shakursiam/ssl16-acoustic-camera/hardware/exports/erc_report.txt

ERC report (2026-10-29T23:49:08, Encoding UTF8)
Report includes: Errors, Warnings

***** Sheet /
[lib_symbol_issues]: The current configuration does not include the symbol library 'PTS526SM15SMTR2 LFS'
    ; warning
    @(172.72 mm, 97.79 mm): Symbol SW4 [PTS526_SM15_SMTR2_LFS]
[lib_symbol_issues]: The current configuration does not include the symbol library 'PTS526SM15SMTR2 LFS'
    ; warning
    @(173.99 mm, 62.23 mm): Symbol SW3 [PTS526_SM15_SMTR2_LFS]
[lib_symbol_issues]: The current configuration does not include the symbol library 'EEEFK1V471AQ_cap'
    ; warning
    @(246.38 mm, 125.73 mm): Symbol C106 [EEEFK1V471AQ]
[lib_symbol_issues]: Symbol '_1' not found in symbol library 'XL2596S-5.0E1'
    ; warning
    @(294.64 mm, 128.27 mm): Symbol U7 [_1]
[footprint_link_issues]: Footprint 'SOT_RG1_DIO' not found in library 'footprints'
    ; warning
    @(303.53 mm, 229.87 mm): Symbol U8 [AP2112K-3.3TRG1]
[lib_symbol_mismatch]: Symbol 'AP2112K-3.3TRG1' doesn't match copy in library 'AP2112K-3.3TRG1'
    ; warning
    @(303.53 mm, 229.87 mm): Symbol U8 [AP2112K-3.3TRG1]
[lib_symbol_issues]: The current configuration does not include the symbol library 'AMRM00101040470'
    ; warning
    @(323.85 mm, 125.73 mm): Symbol L2 [AMRM00101040470MA1]
[lib_symbol_issues]: The current configuration does not include the symbol library 'EEEFK1V471AQ_cap'
    ; warning
    @(350.52 mm, 135.89 mm): Symbol C107 [EEEFK1V471AQ]
[endpoint_off_grid]: Symbol pin or wire end off connection grid
    ; warning
    @(28.575 mm, 41.91 mm): Horizontal Wire, length 15.24 mm
[endpoint_off_grid]: Symbol pin or wire end off connection grid
    ; warning
    @(28.575 mm, 41.91 mm): Vertical Wire, length 36.83 mm
[endpoint_off_grid]: Symbol pin or wire end off connection grid
    ; warning
    @(28.575 mm, 78.74 mm): Horizontal Wire, length 48.895 mm
[endpoint_off_grid]: Symbol pin or wire end off connection grid
    ; warning
    @(43.815 mm, 41.91 mm): Horizontal Wire, length 5.715 mm
[endpoint_off_grid]: Symbol pin or wire end off connection grid
    ; warning
    @(43.815 mm, 46.99 mm): Symbol R601 Pin 2 [Passive, Line]
[endpoint_off_grid]: Symbol pin or wire end off connection grid
    ; warning
    @(43.815 mm, 54.61 mm): Symbol #PWR0601 Pin 1 [Power input, Line]
[endpoint_off_grid]: Symbol pin or wire end off connection grid
    ; warning
    @(43.815 mm, 54.61 mm): Symbol D601 Pin 1 [K, Passive, Line]
[endpoint_off_grid]: Symbol pin or wire end off connection grid
    ; warning
    @(49.53 mm, 41.91 mm): Horizontal Wire, length 0.635 mm
[endpoint_off_grid]: Symbol pin or wire end off connection grid
    ; warning
    @(50.165 mm, 41.91 mm): Vertical Wire, length 5.08 mm
[endpoint_off_grid]: Symbol pin or wire end off connection grid
    ; warning
    @(50.165 mm, 52.07 mm): Vertical Wire, length 3.81 mm
[endpoint_off_grid]: Symbol pin or wire end off connection grid
    ; warning
    @(50.165 mm, 52.07 mm): Symbol C102 Pin 2 [Passive, Line]
[endpoint_off_grid]: Symbol pin or wire end off connection grid
    ; warning
    @(50.165 mm, 55.88 mm): Vertical Wire, length 5.08 mm
[endpoint_off_grid]: Symbol pin or wire end off connection grid
    ; warning
    @(50.165 mm, 60.96 mm): Symbol #PWR0119 Pin 1 [Power input, Line]
[endpoint_off_grid]: Symbol pin or wire end off connection grid
    ; warning
    @(56.515 mm, 41.91 mm): Vertical Wire, length 5.08 mm
[endpoint_off_grid]: Symbol pin or wire end off connection grid
    ; warning
    @(56.515 mm, 41.91 mm): Horizontal Wire, length 6.35 mm
[endpoint_off_grid]: Symbol pin or wire end off connection grid
    ; warning
    @(56.515 mm, 52.07 mm): Symbol C103 Pin 2 [Passive, Line]
[endpoint_off_grid]: Symbol pin or wire end off connection grid
    ; warning
    @(56.515 mm, 52.07 mm): Vertical Wire, length 3.81 mm
[endpoint_off_grid]: Symbol pin or wire end off connection grid
    ; warning
    @(56.515 mm, 55.88 mm): Horizontal Wire, length 6.35 mm
[lib_symbol_issues]: The current configuration does not include the symbol library 'Sd_card'
    ; warning
    @(77.47 mm, 71.12 mm): Symbol J601 [1040310811]
[lib_symbol_mismatch]: Symbol 'R_Small_US' doesn't match copy in library 'Device'
    ; warning
    @(173.355 mm, 31.115 mm): Symbol R604 [R_Small_US]
[endpoint_off_grid]: Symbol pin or wire end off connection grid
    ; warning
    @(173.355 mm, 33.655 mm): Symbol R604 Pin 1 [Passive, Line]
[endpoint_off_grid]: Symbol pin or wire end off connection grid
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
    ; warning
    @(80.01 mm, 64.77 mm): Symbol U2 [TLV320ADC5140IRTWR]
[lib_symbol_issues]: The current configuration does not include the symbol library 'TLV320ADC5140IRTWR'
    ; warning
    @(72.39 mm, 67.31 mm): Symbol U4 [TLV320ADC5140IRTWR]

***** Sheet /MCU/
[pin_to_pin]: Pins of type Output and Power output are connected
    ; error
    @(68.58 mm, 220.98 mm): Symbol U9 Pin 3 [ALERT, Output, Line]
    @(133.35 mm, 81.28 mm): Symbol J601 Pin 6 [VSS, Power output, Line]
[power_pin_not_driven]: Input Power pin not driven by any Output Power pins
    ; error
    @(289.56 mm, 175.26 mm): Symbol #PWR053 Pin 1 [Power input, Line]
[power_pin_not_driven]: Input Power pin not driven by any Output Power pins
    ; error
    @(350.52 mm, 119.38 mm): Symbol #PWR052 Pin 1 [Power input, Line]
[power_pin_not_driven]: Input Power pin not driven by any Output Power pins
    ; error
    @(359.41 mm, 87.63 mm): Symbol #PWR049 Pin 1 [Power input, Line]
[power_pin_not_driven]: Input Power pin not driven by any Output Power pins
    ; error
    @(364.49 mm, 226.06 mm): Symbol #PWR056 Pin 1 [Power input, Line]
[no_connect_dangling]: Unconnected "no connection" flag
    ; warning
    @(66.04 mm, 54.61 mm): No Connect
[no_connect_dangling]: Unconnected "no connection" flag
    ; warning
    @(66.04 mm, 68.58 mm): No Connect
[no_connect_dangling]: Unconnected "no connection" flag
    ; warning
    @(68.58 mm, 54.61 mm): No Connect
[no_connect_dangling]: Unconnected "no connection" flag
    ; warning
    @(68.58 mm, 68.58 mm): No Connect
[multiple_net_names]: Both FSYNC and IO7_WS are attached to the same items; FSYNC will be used in the netlist
    ; warning
    @(76.20 mm, 77.47 mm): Global Label 'FSYNC'
    @(71.12 mm, 78.74 mm): Global Label 'IO7_WS'
[pin_to_pin]: Pins of type Unspecified and Unspecified are connected
    ; warning
    @(157.48 mm, 95.25 mm): Symbol SW4 Pin 1 [1, Unspecified, Line]
    @(157.48 mm, 100.33 mm): Symbol SW4 Pin 2 [2, Unspecified, Line]
[pin_to_pin]: Pins of type Unspecified and Power input are connected
    ; warning
    @(157.48 mm, 100.33 mm): Symbol SW4 Pin 2 [2, Unspecified, Line]
    @(153.67 mm, 102.87 mm): Symbol #PWR072 Pin 1 [Power input, Line]
[pin_to_pin]: Pins of type Unspecified and Unspecified are connected
    ; warning
    @(158.75 mm, 59.69 mm): Symbol SW3 Pin 1 [1, Unspecified, Line]
    @(158.75 mm, 64.77 mm): Symbol SW3 Pin 2 [2, Unspecified, Line]
[pin_to_pin]: Pins of type Unspecified and Power input are connected
    ; warning
    @(158.75 mm, 64.77 mm): Symbol SW3 Pin 2 [2, Unspecified, Line]
    @(154.94 mm, 78.74 mm): Symbol #PWR045 Pin 1 [Power input, Line]
[pin_to_pin]: Pins of type Unspecified and Passive are connected
    ; warning
    @(185.42 mm, 95.25 mm): Symbol SW4 Pin 4 [4, Unspecified, Line]
    @(189.23 mm, 95.25 mm): Symbol TP2_BOOT1 Pin 1 [1, Passive, Line]
[pin_to_pin]: Pins of type Unspecified and Unspecified are connected
    ; warning
    @(185.42 mm, 100.33 mm): Symbol SW4 Pin 3 [3, Unspecified, Line]
    @(185.42 mm, 95.25 mm): Symbol SW4 Pin 4 [4, Unspecified, Line]
[pin_to_pin]: Pins of type Unspecified and Passive are connected
    ; warning
    @(186.69 mm, 59.69 mm): Symbol SW3 Pin 4 [4, Unspecified, Line]
    @(190.50 mm, 64.77 mm): Symbol R2 Pin 1 [Passive, Line]
[pin_to_pin]: Pins of type Unspecified and Passive are connected
    ; warning
    @(186.69 mm, 64.77 mm): Symbol SW3 Pin 3 [3, Unspecified, Line]
    @(190.50 mm, 64.77 mm): Symbol R2 Pin 1 [Passive, Line]
[pin_to_pin]: Pins of type Unspecified and Passive are connected
    ; warning
    @(303.53 mm, 229.87 mm): Symbol U8 Pin 1 [VIN, Unspecified, Line]
    @(294.64 mm, 233.68 mm): Symbol R6 Pin 2 [Passive, Line]
[pin_to_pin]: Pins of type Unspecified and Passive are connected
    ; warning
    @(303.53 mm, 233.68 mm): Symbol U8 Pin 3 [EN, Unspecified, Line]
    @(299.72 mm, 233.68 mm): Symbol R6 Pin 1 [Passive, Line]
[pin_to_pin]: Pins of type Unspecified and Passive are connected
    ; warning
    @(303.53 mm, 237.49 mm): Symbol U8 Pin 2 [GND, Unspecified, Line]
    @(289.56 mm, 241.30 mm): Symbol C57 Pin 1 [Passive, Line]
[pin_to_pin]: Pins of type Unspecified and Output are connected
    ; warning
    @(323.85 mm, 125.73 mm): Symbol L2 Pin 2 [2, Unspecified, Line]
    @(312.42 mm, 128.27 mm): Symbol U7 Pin 2 [5V, Output, Line]
[pin_to_pin]: Pins of type Unspecified and Passive are connected
    ; warning
    @(339.09 mm, 125.73 mm): Symbol L2 Pin 1 [1, Unspecified, Line]
    @(345.44 mm, 125.73 mm): Symbol 5V1 Pin 1 [1, Passive, Line]
[pin_to_pin]: Pins of type Unspecified and Passive are connected
    ; warning
    @(344.17 mm, 229.87 mm): Symbol U8 Pin 5 [VOUT, Unspecified, Line]
    @(354.33 mm, 233.68 mm): Symbol C58 Pin 2 [Passive, Line]

***** Sheet /SD Card/
[pin_to_pin]: Pins of type Unspecified and Passive are connected
    ; warning
    @(77.47 mm, 76.20 mm): Symbol J601 Pin 3 [CMD, Unspecified, Line]
    @(178.435 mm, 33.655 mm): Symbol R606 Pin 1 [Passive, Line]
[pin_to_pin]: Pins of type Unspecified and Bidirectional are connected
    ; warning
    @(77.47 mm, 81.28 mm): Symbol J601 Pin 5 [CLK, Unspecified, Line]
    @(87.63 mm, 73.66 mm): Symbol U5 Pin 5 [IO5, Bidirectional, Line]
[pin_to_pin]: Pins of type Unspecified and Power input are connected
    ; warning
    @(133.35 mm, 71.12 mm): Symbol J601 Pin 10 [SW_DETECT, Unspecified, Line]
    @(139.70 mm, 68.58 mm): Symbol #PWR0122 Pin 1 [Power input, Line]
[pin_to_pin]: Pins of type Unspecified and Passive are connected
    ; warning
    @(133.35 mm, 73.66 mm): Symbol J601 Pin 9 [SW_DETECT, Unspecified, Line]
    @(182.88 mm, 36.83 mm): Symbol R607 Pin 1 [Passive, Line]

***** Sheet /ADC_1/
[power_pin_not_driven]: Input Power pin not driven by any Output Power pins
    ; error
    @(49.53 mm, 52.07 mm): Symbol U1 Pin 2 [AREG, Power input, Line]
[power_pin_not_driven]: Input Power pin not driven by any Output Power pins
    ; error
    @(167.64 mm, 54.61 mm): Symbol MK2 Pin 2 [V_{DD}, Power input, Line]
[pin_to_pin]: Pins of type Unspecified and Passive are connected
    ; warning
    @(49.53 mm, 62.23 mm): Symbol U1 Pin 3 [VREF, Unspecified, Line]
    @(46.99 mm, 62.23 mm): Symbol C77 Pin 2 [Passive, Line]
[pin_to_pin]: Pins of type Unspecified and Passive are connected
    ; warning
    @(49.53 mm, 82.55 mm): Symbol U1 Pin 5 [MICBIAS, Unspecified, Line]
    @(41.91 mm, 82.55 mm): Symbol C100 Pin 2 [Passive, Line]
[pin_to_pin]: Pins of type Bidirectional and Power output are connected
    ; warning
    @(95.25 mm, 62.23 mm): Symbol U1 Pin 15 [ADDR1_MISO, Bidirectional, Line]
    @(133.35 mm, 81.28 mm): Symbol J601 Pin 6 [VSS, Power output, Line]
[pin_to_pin]: Pins of type Unspecified and Power input are connected
    ; warning
    @(95.25 mm, 163.83 mm): Symbol U1 Pin 25 [EPAD, Unspecified, Line]
    @(95.25 mm, 165.10 mm): Symbol #PWR0155 Pin 1 [Power input, Line]

***** Sheet /ADC_3/
[power_pin_not_driven]: Input Power pin not driven by any Output Power pins
    ; error
    @(52.07 mm, 50.80 mm): Symbol U3 Pin 2 [AREG, Power input, Line]
[power_pin_not_driven]: Input Power pin not driven by any Output Power pins
    ; error
    @(170.18 mm, 53.34 mm): Symbol MK3 Pin 2 [V_{DD}, Power input, Line]
[pin_to_pin]: Pins of type Unspecified and Passive are connected
    ; warning
    @(52.07 mm, 60.96 mm): Symbol U3 Pin 3 [VREF, Unspecified, Line]
    @(49.53 mm, 60.96 mm): Symbol C78 Pin 2 [Passive, Line]
[pin_to_pin]: Pins of type Unspecified and Passive are connected
    ; warning
    @(52.07 mm, 81.28 mm): Symbol U3 Pin 5 [MICBIAS, Unspecified, Line]
    @(44.45 mm, 81.28 mm): Symbol C101 Pin 2 [Passive, Line]
[pin_to_pin]: Pins of type Unspecified and Power input are connected
    ; warning
    @(97.79 mm, 162.56 mm): Symbol U3 Pin 25 [EPAD, Unspecified, Line]
    @(97.79 mm, 163.83 mm): Symbol #PWR0173 Pin 1 [Power input, Line]

***** Sheet /ADC_4/
[power_pin_not_driven]: Input Power pin not driven by any Output Power pins
    ; error
    @(50.80 mm, 50.80 mm): Symbol U4 Pin 2 [AREG, Power input, Line]
[power_pin_not_driven]: Input Power pin not driven by any Output Power pins
    ; error
    @(168.91 mm, 53.34 mm): Symbol MK5 Pin 2 [V_{DD}, Power input, Line]
[pin_to_pin]: Pins of type Unspecified and Passive are connected
    ; warning
    @(50.80 mm, 60.96 mm): Symbol U4 Pin 3 [VREF, Unspecified, Line]
    @(48.26 mm, 60.96 mm): Symbol C79 Pin 2 [Passive, Line]
[pin_to_pin]: Pins of type Unspecified and Passive are connected
    ; warning
    @(50.80 mm, 81.28 mm): Symbol U4 Pin 5 [MICBIAS, Unspecified, Line]
    @(43.18 mm, 81.28 mm): Symbol C110 Pin 2 [Passive, Line]
[pin_to_pin]: Pins of type Unspecified and Power input are connected
    ; warning
    @(96.52 mm, 162.56 mm): Symbol U4 Pin 25 [EPAD, Unspecified, Line]
    @(96.52 mm, 163.83 mm): Symbol #PWR0191 Pin 1 [Power input, Line]

***** Sheet /ADC_2/
[power_pin_not_driven]: Input Power pin not driven by any Output Power pins
    ; error
    @(35.56 mm, 33.02 mm): Symbol #PWR083 Pin 1 [Power input, Line]
[power_pin_not_driven]: Input Power pin not driven by any Output Power pins
    ; error
    @(58.42 mm, 48.26 mm): Symbol U2 Pin 2 [AREG, Power input, Line]
[power_pin_not_driven]: Input Power pin not driven by any Output Power pins
    ; error
    @(176.53 mm, 50.80 mm): Symbol MK1 Pin 2 [V_{DD}, Power input, Line]
[pin_to_pin]: Pins of type Unspecified and Passive are connected
    ; warning
    @(58.42 mm, 58.42 mm): Symbol U2 Pin 3 [VREF, Unspecified, Line]
    @(55.88 mm, 58.42 mm): Symbol C76 Pin 2 [Passive, Line]
[pin_to_pin]: Pins of type Unspecified and Passive are connected
    ; warning
    @(58.42 mm, 78.74 mm): Symbol U2 Pin 5 [MICBIAS, Unspecified, Line]
    @(50.80 mm, 78.74 mm): Symbol C99 Pin 2 [Passive, Line]
[pin_to_pin]: Pins of type Bidirectional and Power output are connected
    ; warning
    @(104.14 mm, 58.42 mm): Symbol U2 Pin 15 [ADDR1_MISO, Bidirectional, Line]
    @(133.35 mm, 81.28 mm): Symbol J601 Pin 6 [VSS, Power output, Line]
[pin_to_pin]: Pins of type Unspecified and Power input are connected
    ; warning
    @(104.14 mm, 160.02 mm): Symbol U2 Pin 25 [EPAD, Unspecified, Line]
    @(104.14 mm, 161.29 mm): Symbol #PWR0144 Pin 1 [Power input, Line]

***** Sheet /TDM/
[power_pin_not_driven]: Input Power pin not driven by any Output Power pins
    ; error
    @(114.30 mm, 121.92 mm): Symbol Y1 Pin 4 [VDD, Power input, Line]
[multiple_net_names]: Both I2S_DIN and IO13_DIN are attached to the same items; I2S_DIN will be used in the netlist
    ; warning
    @(248.92 mm, 118.11 mm): Global Label 'I2S_DIN'
    @(267.97 mm, 139.70 mm): Global Label 'IO13_DIN'
[multiple_net_names]: Both FSYNC and IO7_WS are attached to the same items; FSYNC will be used in the netlist
    ; warning
    @(243.84 mm, 142.24 mm): Global Label 'FSYNC'
    @(267.97 mm, 142.24 mm): Global Label 'IO7_WS'
[multiple_net_names]: Both BCLK_Y3 and IO6_BCLK are attached to the same items; BCLK_Y3 will be used in the netlist
    ; warning
    @(176.53 mm, 57.15 mm): Global Label 'BCLK_Y3'
    @(267.97 mm, 144.78 mm): Global Label 'IO6_BCLK'

 ** ERC messages: 107  Errors 15  Warnings 92

 ** Ignored checks:
    - Global label only appears once in the schematic
    - Four connection points are joined together
    - SPICE model issue
    - Assigned footprint doesn't match footprint filters
