shakursiam/ssl16-acoustic-camera/hardware/fabrication/rev_A/assembly/BOM_JLCPCB_Assembly_RevA.csv

Designator | Comment | Footprint | JLCPCB Part # | Matches | Part # | Manufacturer | Footprint | Description | Category | Warning | JLCPCB Part # | Product link | Lib Type | Qty | Source | Total Price ($)
C1,C2,C3,C4,C5,C6,C7,C8,C9,C10,C11,C12,C13,C14,C15,C16,C17,C18,C19,C20,C21,C22,C23,C24,C25,C26,C27,C28,C29,C30,C31,C32,C33,C34,C35,C36,C37,C38,C39,C40,C41,C42,C43,C44,C45,C46,C47,C48,C51,C61,C68,C76,C77,C78,C79,C99,C100,C101,C109,C110,C124 | 1uF25VX5R0402 | C_0402_1005Metric |  | Select by System | CL05A105KA5NQNC | Samsung Electro-Mechanics | 0402 | 1uF 25V X5R ±10% 0402 Multilayer Ceramic Capacitors MLCC - SMD/SMT ROHS | Multilayer Ceramic Capacitors MLCC - SMD/SMT |  | C52923 | https://jlcpcb.com/partdetail/53938-CL05A105KA5NQNC/C52923 | Basic | 132.0 | 132 JLCPCB | 0.8448
C49 | 22uF25VX5R1206 | C_1206_3216Metric |  | Select by System | CL31A226KAHNNNE | Samsung Electro-Mechanics | 1206 | 22uF 25V X5R ±10% 1206 Multilayer Ceramic Capacitors MLCC - SMD/SMT ROHS | Multilayer Ceramic Capacitors MLCC - SMD/SMT |  | C12891 | https://jlcpcb.com/partdetail/13537-CL31A226KAHNNNE/C12891 | Basic | 6.0 | 6 JLCPCB | 1.0038
C50,C52,C53,C60,C62,C63,C64,C65,C66,C67,C80,C81,C82,C83,C85,C86,C87,C94,C97,C98,C104,C105,C108,C113,C116,C119,C122 | 100nF16VX7R0402 | C_0402_1005Metric |  | Select by System | CL05B104KO5NNNC | Samsung Electro-Mechanics | 0402 | 100nF 16V X7R ±10% 0402 Multilayer Ceramic Capacitors MLCC - SMD/SMT ROHS | Multilayer Ceramic Capacitors MLCC - SMD/SMT |  | C1525 | https://jlcpcb.com/partdetail/1877-CL05B104KO5NNNC/C1525 | Basic | 64.0 | 64 JLCPCB | 0.1984
C54 | 100pF50VC0G0402 | C_0402_1005Metric |  | Select by System | 0402CG101J500NT | FH (Guangdong Fenghua Advanced Tech) | 0402 | 100pF 50V C0G ±5% 0402 Multilayer Ceramic Capacitors MLCC - SMD/SMT ROHS | Multilayer Ceramic Capacitors MLCC - SMD/SMT |  | C1546 | https://jlcpcb.com/partdetail/1898-0402CG101J500NT/C1546 | Basic | 20.0 | 20 JLCPCB | 0.06
C55,C56 | 1uF50VX7R1206 | C_1206_3216Metric |  | Select by System | CL31B105KBHNNNE | Samsung Electro-Mechanics | 1206 | 1uF 50V X7R ±10% 1206 Multilayer Ceramic Capacitors MLCC - SMD/SMT ROHS | Multilayer Ceramic Capacitors MLCC - SMD/SMT |  | C1848 | https://jlcpcb.com/partdetail/2200-CL31B105KBHNNNE/C1848 | Basic | 15.0 | 15 JLCPCB | 0.9315
C57,C58,C59 | 10uF10VX5R0603 | C_0603_1608Metric |  | Select by System | CL10A106KP8NNNC | Samsung Electro-Mechanics | 0603 | 10V 10uF X5R ±10% 0603 Multilayer Ceramic Capacitors MLCC - SMD/SMT ROHS | Multilayer Ceramic Capacitors MLCC - SMD/SMT |  | C19702 | https://jlcpcb.com/partdetail/20411-CL10A106KP8NNNC/C19702 | Basic | 20.0 | 20 JLCPCB | 0.424
C88,C89,C90,C91,C92,C93,C95,C96,C111,C112,C114,C115,C117,C118,C120,C121,C123 | 10uF25VX5R0805 | C_0805_2012Metric |  | Select by System | CL21A106KAYNNNE | Samsung Electro-Mechanics | 0805 | 10uF 25V X5R ±10% 0805 Multilayer Ceramic Capacitors MLCC - SMD/SMT ROHS | Multilayer Ceramic Capacitors MLCC - SMD/SMT |  | C15850 | https://jlcpcb.com/partdetail/16532-CL21A106KAYNNNE/C15850 | Basic | 44.0 | 44 JLCPCB | 1.9272
C102 | 100nF50VX7R0603 | C_0603_1608Metric |  | Select by System | CC0603KRX7R9BB104 | YAGEO | 0603 | 100nF 50V X7R ±10% 0603 Multilayer Ceramic Capacitors MLCC - SMD/SMT ROHS | Multilayer Ceramic Capacitors MLCC - SMD/SMT |  | C14663 | https://jlcpcb.com/partdetail/YAGEO-CC0603KRX7R9BB104/C14663 | Basic | 20.0 | 20 JLCPCB | 0.204
C103 | 1uF50VX5R0603 | C_0603_1608Metric |  | Select by System | CL10A105KB8NNNC | Samsung Electro-Mechanics | 0603 | 1uF 50V X5R ±10% 0603 Multilayer Ceramic Capacitors MLCC - SMD/SMT ROHS | Multilayer Ceramic Capacitors MLCC - SMD/SMT |  | C15849 | https://jlcpcb.com/partdetail/16531-CL10A105KB8NNNC/C15849 | Basic | 20.0 | 20 JLCPCB | 0.292
C106,C107 | EEE-FK1V471AQ470uF35V | CAP_EEEFK1V471AQ |  | Select by Customer | RVT1V471M1010 | Honor Elec | SMD,D10xL10.2mm | -55℃~+105℃ 10.2mm 10mm 2000hrs@105℃ 35V 470uF ±20% SMD,D10xL10.2mm Aluminum Electrolytic Capacitors - SMD ROHS | Aluminum Electrolytic Capacitors - SMD |  | C3350 | https://jlcpcb.com/partdetail/HonorElec-RVT1V471M1010/C3350 | Extended | 5.0 | 5 JLCPCB | 0.5735
D1 | B5818WS-TP1A30VSOD-323 | D_SOD-323 |  | Select by Customer | B5818WS | Shandong Jingdao Microelectronics | SOD-323 | -55℃~+150℃ 1 Independent 1A 1mA@30V 30V 550mV@1A 9A SOD-323 Schottky Diodes ROHS | Schottky Diodes |  | C353565 | https://jlcpcb.com/partdetail/329314-B5818WS/C353565 | Extended | 20.0 | 20 JLCPCB | 0.352
D2 | PMEG4050EP5A40VSOD-128 | SODFL4725X110N |  | Select by System | PMEG4050EP,115 | Nexperia | SOD-128 | 1 Independent 300uA@40V 40V 490mV@5A 5A 70A SOD-128 Schottky Diodes ROHS | Schottky Diodes |  | C96235 | https://jlcpcb.com/partdetail/Nexperia-PMEG4050EP115/C96235 | Extended | 5.0 | 5 JLCPCB | 1.302
D3 | LEDBlue0603 | LED_0603_1608Metric |  | Select by Customer | KT-0603B | Hubei KENTO Elec | 0603 | 100mW 120° 175mcd 3.1V 460nm~475nm 469nm 5mA Blue Discrete Diode Water Clear 0603 LED Indication - Discrete ROHS | LED Indication - Discrete |  | C2288 | https://jlcpcb.com/partdetail/Hubei_KENTOElec-KT0603B/C2288 | Extended | 20.0 | 20 JLCPCB | 0.208
D4 | LEDGreen0603 | LED_0603_1608Metric |  | Select by Customer | KT-0603YG | Hubei KENTO Elec | 0603 | -40℃~+85℃ 120° 20mA 2V~2.2V 30mcd~42mcd 40mW 567nm~573nm 576nm Discrete Diode Top-mount Water Clear Yellow Green 0603 LED Indication - Discrete ROHS | LED Indication - Discrete |  | C2289 | https://jlcpcb.com/partdetail/Hubei_KENTOElec-KT0603YG/C2289 | Extended | 20.0 | 20 JLCPCB | 0.208
D5 | LEDYellow0603 | LED_0603_1608Metric |  | Select by Customer | KT-0603W | Hubei KENTO Elec | 0603 | -40℃~+85℃ 100mW 120° 2.6V~3.1V 360mcd 5mA Discrete Diode Top-mount White Yellow Lens 0603 LED Indication - Discrete ROHS | LED Indication - Discrete |  | C2290 | https://jlcpcb.com/partdetail/Hubei_KENTOElec-KT0603W/C2290 | Basic | 20.0 | 20 JLCPCB | 0.246
D6 | WS2812B-B/W5050 | LED_WS2812B_PLCC4_5.0x5.0mm_P3.2mm |  | Select by Customer | WS2812B-B/T | Worldsemi | SMD5050-4P | 0.6mA 1.57mm 2kHz 3.7V~5.3V 5.4mm 5mm 800Kbit/s Built-in power-on reset circuit、Built-in power-on reset circuit、Built-in one-way transmission function G:520nm、B:471nm、R:621nm G:520nm、B:471nm、R:621nm G:600mcd~1000mcd、B:200mcd~300mcd、R:300mcd~500mcd SMD5050-4P RGB LEDs(Built-in IC) ROHS | RGB LEDs(Built-In IC) |  | C2761795 | https://jlcpcb.com/partdetail/Worldsemi-WS2812B_BT/C2761795 | Extended | 6.0 | 6 JLCPCB | 0.7038
D601 | LTST-C281TGKT-5AgreenLED0402 | LED_0402_1005Metric |  | Select by System | LTST-C281TGKT-5A | Lite-On | 0402 | -20℃~+80℃ 130° 1mm x 0.5mm square LED 2.5V~3.1V 28mcd~280mcd 520nm~535nm 525nm 76mW Discrete Diode Green Water Clear 0402 LED Indication - Discrete ROHS | LED Indication - Discrete |  | C364549 | https://jlcpcb.com/partdetail/LiteOn-LTST_C281TGKT5A/C364549 | Extended | 6.0 | 6 JLCPCB | 0.4602
FB1 | BLM15AG601SN1D | BEADC1005X55N |  | Select by System | BLM15AG601SN1D | Murata Electronics | 0402 | -55℃~+125℃ 1 300mA 520mΩ 600Ω@100MHz ±25% 0402 Ferrite Beads ROHS | Ferrite Beads |  | C76884 | https://jlcpcb.com/partdetail/MurataElectronics-BLM15AG601SN1D/C76884 | Extended | 20.0 | 20 JLCPCB | 0.182
J2 | USB4105-GF-AUSB-C16P | GCT_USB4105-GF-A-060 |  | Select by Customer | USB4105-GF-A-060 | Global Connector Technology | SMD | -40℃~+85℃ 1 12P 48V 5A Black Female Surface Mount, Right Angle Type-C USB 2.0 SMD USB Connectors ROHS | USB Connectors |  | C3025063 | https://jlcpcb.com/partdetail/3554049-USB4105_GF_A060/C3025063 | Extended | 2.0 | 2 JLCPCB | 2.9316
J8 | DC-005-5A-2.0barreljack2.0mmpin(THT) | GCT_DCJ200-10-A-XX-K_REVA |  | Select by System | DC-005-5A-2.0 | XKB Connection | 插件 | -20℃~+70℃ 24V 2mm 5A 6.2mm DC Power Jack Right Angle 插件 DC Power Connectors ROHS | DC Power Connectors |  | C381116 | https://jlcpcb.com/partdetail/XKBConnection-DC_005_5A_20/C381116 | Extended | 2.0 | 2 JLCPCB | 0.5262
J601 | Molex104031-0811microSD | 104031-0811_MOL |  | Select by System | 1040310811 | MOLEX | SMD | -25℃~+85℃ 1.42mm Connector and Ejector MicroSD Card (TF Card) Push-Pull SMD SD Card / Memory Card Connector ROHS | SD Card / Memory Card Connector |  | C585350 | https://jlcpcb.com/partdetail/MOLEX-1040310811/C585350 | Extended | 2.0 | 2 JLCPCB | 1.5198
L2 | CYA1040-47UH47uH3A | IND_AMRM00101040_PUL |  | Select by System | CYA1040-47UH | SHOU HAN | SMD,11.6x10.1mm | 129mΩ 3A 47uH 4A ±20% SMD,11.6x10.1mm Molding Power Inductors ROHS | Inductors (SMD) |  | C6364681 | https://jlcpcb.com/partdetail/SHOUHAN-CYA104047UH/C6364681 | Extended | 2.0 | 2 JLCPCB | 0.4882
MK1,MK2,MK3,MK4,MK5,MK6,MK7,MK8,MK9,MK10,MK11,MK12,MK13,MK14,MK15,MK16 | IM73A135V01XTSA1 | Infineon_PG-LLGA-5-2 |  | Select by Customer | IM73A135V01XTSA1 | Infineon Technologies | LLGA-5(4x3) | -38dB 1.2mm 170uA 2.75V 3mm 4mm 73dB Differential output Omnidirectional Omnidirectional pickup LLGA-5(4x3) MEMS Microphones ROHS | MEMS Microphones |  | C3171831 | https://jlcpcb.com/partdetail/3733768-IM73A135V01XTSA1/C3171831 | Extended | 32.0 | 32 JLCPCB | 87.1008
Q1 | DMP2045U-7 | SOT-23 |  | Select by System | DMP2045U-7 | Diodes Incorporated | SOT-23 | -55℃~+150℃ 1 P-Channel 1V 20V 4.3A 6.8nC 634pF 66pF 800mW 90mΩ@1.8V SOT-23 MOSFETs ROHS | MOSFETs |  | C459541 | https://jlcpcb.com/partdetail/DiodesIncorporated-DMP2045U7/C459541 | Extended | 6.0 | 6 JLCPCB | 0.8874
R1,R5,R6,R21,R29,R602,R603,R604,R605,R606,R607 | 10k1%0402 | R_0402_1005Metric |  | Select by System | 0402WGF1002TCE | UNI-ROYAL(Uniroyal Elec) | 0402 | -55℃~+155℃ 10kΩ 50V 62.5mW Thick Film Resistor ±1% ±100ppm/℃ 0402 Chip Resistor - Surface Mount ROHS | Chip Resistor - Surface Mount |  | C25744 | https://jlcpcb.com/partdetail/26487-0402WGF1002TCE/C25744 | Basic | 32.0 | 32 JLCPCB | 0.0768
R2 | 0R0402 | R_0402_1005Metric |  | Select by System | 0402WGF0000TCE | UNI-ROYAL(Uniroyal Elec) | 0402 | -55℃~+155℃ 0Ω 50V 62.5mW Thick Film Resistor ±1% ±800ppm/℃ 0402 Chip Resistor - Surface Mount ROHS | Chip Resistor - Surface Mount |  | C17168 | https://jlcpcb.com/partdetail/17853-0402WGF0000TCE/C17168 | Basic | 20.0 | 20 JLCPCB | 0.024
R3,R4 | 5.1k1%0402 | R_0402_1005Metric |  | Select by System | 0402WGF5101TCE | UNI-ROYAL(Uniroyal Elec) | 0402 | -55℃~+155℃ 5.1kΩ 50V 62.5mW Thick Film Resistor ±1% ±100ppm/℃ 0402 Chip Resistor - Surface Mount ROHS | Chip Resistor - Surface Mount |  | C25905 | https://jlcpcb.com/partdetail/26648-0402WGF5101TCE/C25905 | Basic | 20.0 | 20 JLCPCB | 0.046
R7,R8,R9 | 1k1%0402 | R_0402_1005Metric |  | Select by System | 0402WGF1001TCE | UNI-ROYAL(Uniroyal Elec) | 0402 | -55℃~+155℃ 1kΩ 50V 62.5mW Thick Film Resistor ±1% ±100ppm/℃ 0402 Chip Resistor - Surface Mount ROHS | Chip Resistor - Surface Mount |  | C11702 | https://jlcpcb.com/partdetail/12256-0402WGF1001TCE/C11702 | Basic | 20.0 | 20 JLCPCB | 0.026
R13,R14,R15,R16,R22,R23,R24,R25,R26,R27,R28 | 33R1%0402 | R_0402_1005Metric |  | Select by System | 0402WGF330JTCE | UNI-ROYAL(Uniroyal Elec) | 0402 | -55℃~+155℃ 33Ω 50V 62.5mW Thick Film Resistor ±1% ±100ppm/℃ 0402 Chip Resistor - Surface Mount ROHS | Chip Resistor - Surface Mount |  | C25105 | https://jlcpcb.com/partdetail/25848-0402WGF330JTCE/C25105 | Basic | 32.0 | 32 JLCPCB | 0.048
R17,R18 | 2.2k1%0402 | R_0402_1005Metric |  | Select by System | 0402WGF2201TCE | UNI-ROYAL(Uniroyal Elec) | 0402 | -55℃~+155℃ 2.2kΩ 50V 62.5mW Thick Film Resistor ±1% ±100ppm/℃ 0402 Chip Resistor - Surface Mount ROHS | Chip Resistor - Surface Mount |  | C25879 | https://jlcpcb.com/partdetail/26622-0402WGF2201TCE/C25879 | Basic | 20.0 | 20 JLCPCB | 0.022
R20 | 330R1%0402 | R_0402_1005Metric |  | Select by System | 0402WGF3300TCE | UNI-ROYAL(Uniroyal Elec) | 0402 | -55℃~+155℃ 330Ω 50V 62.5mW Thick Film Resistor ±1% ±100ppm/℃ 0402 Chip Resistor - Surface Mount ROHS | Chip Resistor - Surface Mount |  | C25104 | https://jlcpcb.com/partdetail/25847-0402WGF3300TCE/C25104 | Basic | 20.0 | 20 JLCPCB | 0.022
R30 | 51R1%0402 | R_0402_1005Metric |  | Select by System | 0402WGF510JTCE | UNI-ROYAL(Uniroyal Elec) | 0402 | -55℃~+155℃ 50V 51Ω 62.5mW Thick Film Resistor ±1% ±100ppm/℃ 0402 Chip Resistor - Surface Mount ROHS | Chip Resistor - Surface Mount |  | C25125 | https://jlcpcb.com/partdetail/25868-0402WGF510JTCE/C25125 | Extended | 20.0 | 20 JLCPCB | 0.024
R31 | 100k1%0402 | R_0402_1005Metric |  | Select by System | 0402WGF1003TCE | UNI-ROYAL(Uniroyal Elec) | 0402 | -55℃~+155℃ 100kΩ 50V 62.5mW Thick Film Resistor ±1% ±100ppm/℃ 0402 Chip Resistor - Surface Mount ROHS | Chip Resistor - Surface Mount |  | C25741 | https://jlcpcb.com/partdetail/26484-0402WGF1003TCE/C25741 | Basic | 20.0 | 20 JLCPCB | 0.03
R601 | 2k1%0402 | R_0402_1005Metric |  | Select by System | 0402WGF2001TCE | UNI-ROYAL(Uniroyal Elec) | 0402 | -55℃~+155℃ 2kΩ 50V 62.5mW Thick Film Resistor ±1% ±100ppm/℃ 0402 Chip Resistor - Surface Mount ROHS | Chip Resistor - Surface Mount |  | C4109 | https://jlcpcb.com/partdetail/4516-0402WGF2001TCE/C4109 | Basic | 20.0 | 20 JLCPCB | 0.052
SW3,SW4 | PTS526tactileswitch | SON4_PTS526SM15SMTR2LFS_CNK |  | Select by System | PTS526SP15SMTR2 LFS | C&K | SMD,5.2x5.2mm | 1.5mm 100,000 cycles 12V 3.2N 5.2mm 5.2mm 50mA No Round Button SMD(SMT) Tab SPST Without Bracket SMD,5.2x5.2mm Tactile Switches ROHS | Tactile Switches |  | C2991193 | https://jlcpcb.com/partdetail/CK-PTS526SP15SMTR2LFS/C2991193 | Extended | 5.0 | 5 JLCPCB | 0.728
U1,U2,U3,U4 | TLV320ADC5140IRTWR | RTW24_4P15X4P15_TEX |  | Select by System | TLV320ADC5140IRTWR | Texas Instruments | WQFN-24(4x4) | -40℃~+125℃ 0.5uA 1.375V、2.5V、2.75V 1.8V~3.6V 24 4 768kHz Audio Analog-to-Digital Converter SPI、I2C WQFN-24(4x4) ADCs/DACs - Special Purpose ROHS | ADCs/DACs - Special Purpose |  | C2876368 | https://jlcpcb.com/partdetail/3084980-TLV320ADC5140IRTWR/C2876368 | Extended | 8.0 | 8 JLCPCB | 32.0856
U5 | ESP32-S3-WROOM-1-N8R8 | ESP32-S3-WROOM-1 |  | Select by System | ESP32-S3-WROOM-1-N8R8 | Espressif Systems | SMD,25.5x18mm | -104.5dBm -40℃~+65℃ 2.4GHz 20.5dBm 330mA 3V~3.6V 97mA Bluetooth5.0 ESP32-S3R8 On-board PCB Antenna UART、SPI、I2C、GPIO、I2S、USB SMD,25.5x18mm WiFi Modules ROHS | WiFi Modules |  | C2913201 | https://jlcpcb.com/partdetail/3198299-ESP32_S3_WROOM_1N8R8/C2913201 | Extended | 2.0 | 2 JLCPCB | 10.0816
U6 | USBLC6-2SC6 | SOT-23-6 |  | Select by System | USBLC6-2SC6 | STMicroelectronics | SOT-23-6L | -40℃~+125℃ 150nA 17V 2 3.5pF 5.25V 5A 6V ESD IEC 61000-4-2 Unidirectional SOT-23-6L ESD and Surge Protection (TVS/ESD) ROHS | ESD And Surge Protection (TVS/ESD) |  | C7519 | https://jlcpcb.com/partdetail/STMicroelectronics-USBLC62SC6/C7519 | Extended | 5.0 | 5 JLCPCB | 0.899
U7 | XL2596S-5.0E1 | TO-263-5_TabPin3 |  | Select by System | XL2596S-5.0E1 | XLSEMI | TO-263-5 | -40℃~+85℃@(TA) 1 150kHz 2mA 3A 4.5V~40V 5V Buck Buck Built-in Fixed No TO-263-5 DC-DC Converters ROHS | DC-DC Converters |  | C74190 | https://jlcpcb.com/partdetail/XLSEMI-XL2596S_50E1/C74190 | Extended | 5.0 | 5 JLCPCB | 2.473
U8 | AP2112K-3.3TRG1 | SOT_RG1_DIO |  | Select by System | AP2112K-3.3TRG1 | Diodes Incorporated | SOT-25-5 | -40℃~+85℃@(Ta) 1 250mV@(600mA) 3.3V 50uVrms 55uA 600mA 65dB@(1kHz) 6V Fixed Over Current Protection、Thermal Shutdown、Enable control Positive SOT-25-5 Voltage Regulators - Linear, Low Drop Out (LDO) Regulators ROHS | Voltage Regulators - Linear, Low Drop Out (LDO) Regulators |  | C51118 | https://jlcpcb.com/partdetail/DiodesIncorporated-AP2112K_33TRG1/C51118 | Extended | 5.0 | 5 JLCPCB | 0.8875
U9 | TMP112AIDRLR | DRL0006A |  | Select by System | TMP112AIDRLR | Texas Instruments | SOT-563 | -40℃~+125℃ 1.4V~3.6V 13bit 1uA 26ms Factory temperature calibration、Temperature threshold monitoring、Low power standby、Configurable temperature output、Hardware comparator / independent temperature control output I2C ±0.5℃ SOT-563 Temperature Sensors ROHS | Temperature Sensors |  | C28927 | https://jlcpcb.com/partdetail/TexasInstruments-TMP112AIDRLR/C28927 | Extended | 5.0 | 5 JLCPCB | 1.5235
U10 | LMK1C1104PWR | PW0008A-IPC_A |  | Select by System | LMK1C1104PWR | Texas Instruments | TSSOP-8 | -40℃~+125℃ 1 1.71V、1.89V~3.135V、2.375V、2.625V、3.465V 250MHz 4 Multi-channel fan-out/isolation drive、Output enable/shutdown TSSOP-8 Clock Buffers, Drivers, Distributors ROHS | Clock Buffers, Drivers |  | C1855734 | https://jlcpcb.com/partdetail/TexasInstruments-LMK1C1104PWR/C1855734 | Extended | 2.0 | 2 JLCPCB | 2.509
U11 | TPS7A2033PDBVR | SOT95P280X145-5N |  | Select by System | TPS7A2033PDBVR | Texas Instruments | SOT-23-5 | -40℃~+125℃@(Tj) 1 10uVrms 140mV@(300mA) 3.3V 300mA 65dB@(100kHz) 6V 8.5uA Fixed Over Current Protection、Short Circuit Protection、Thermal shutdown、Enable control、Input under-voltage protection、Output discharge、Built-in soft-start Positive SOT-23-5 Voltage Regulators - Linear, Low Drop Out (LDO) Regulators ROHS | Voltage Regulators - Linear, Low Drop Out (LDO) Regulators |  | C2862740 | https://jlcpcb.com/partdetail/TexasInstruments-TPS7A2033PDBVR/C2862740 | Extended | 5.0 | 5 JLCPCB | 1.046
Y1 | ASE-24.576MHZ-LC-T3.3VCMOSXO | XTAL_ASE-24.576MHZ-LC-T |  | Select by System | ASE-24.576MHZ-LC-T | Abracon LLC | SMD3225-4P | -40℃~+85℃ 13mA 24.576MHz 3.3V ±50ppm SMD3225-4P Crystal Oscillators ROHS | Global Sourcing Parts |  | C6159263 | https://jlcpcb.com/partdetail/AbraconLLC-ASE_24_576MHZ_LCT/C6159263 | Extended | 2.0 | 2 JLCPCB | 5.7548
