shakursiam/ssl16-acoustic-camera/(list of files, cad)

Other CAD files:
hardware/kicad/Library_BeamForming/BLM15AG601SN1D/BLM15AG601SN1D.step
hardware/kicad/Library_BeamForming/DCJ200-10-A-XX-K_REVA/DCJ200-10-A-XX-K_REVA.step
hardware/kicad/Library_BeamForming/EEEFK1V471AQ_cap/EEEFK1V471AQ.step
hardware/kicad/Library_BeamForming/LIB_SK54AFL-TP/SK54AFL-TP/3D/SK54AFL-TP.stp
hardware/kicad/Library_BeamForming/SS54FSH/SS54FSH.step
hardware/kicad/Library_BeamForming/USB4105_GF_A_060 (2)/USB4105-GF-A-060.step
hardware/kicad/Library_BeamForming/LIB_SK54AFL-TP/SK54AFL-TP/Allegro/sk54afltp.psm
hardware/kicad/Library_BeamForming/LIB_SK54AFL-TP/SK54AFL-TP/DEHDL/sk54afl_tp/chips/chips.prt
