shakursiam/ssl16-acoustic-camera/(list of files, drawings)

Other design files:
hardware/kicad/Library_BeamForming/LIB_SK54AFL-TP/SK54AFL-TP/Altium/SK54AFL-TP.SchLib
hardware/kicad/Library_BeamForming/LIB_SK54AFL-TP/SK54AFL-TP/Altium/SK54AFLTP.PcbLib
