shakursiam/ssl16-acoustic-camera/hardware/kicad/Beamfoarming_16x.kicad_pcb

## KiCad design hardware/kicad/Beamfoarming_16x.kicad_pcb (2026-10-29)

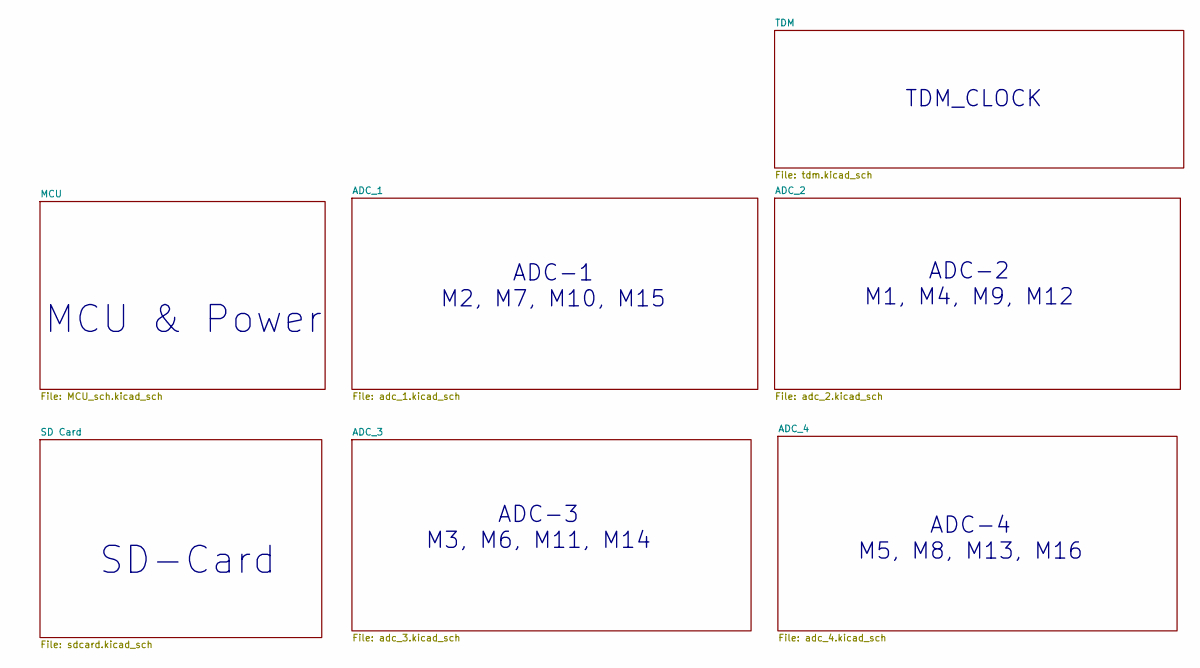
[picture p1: schematic Beamfoarming_16x.kicad_sch, Sound Source Localization_Beam forming]

Notes on the sheet:
ADC-4 M5, M8, M13, M16
ADC-3 M3, M6, M11, M14
ADC-2 M1, M4, M9, M12
TDM_CLOCK
SD-Card
ADC-1 M2, M7, M10, M15
MCU & Power

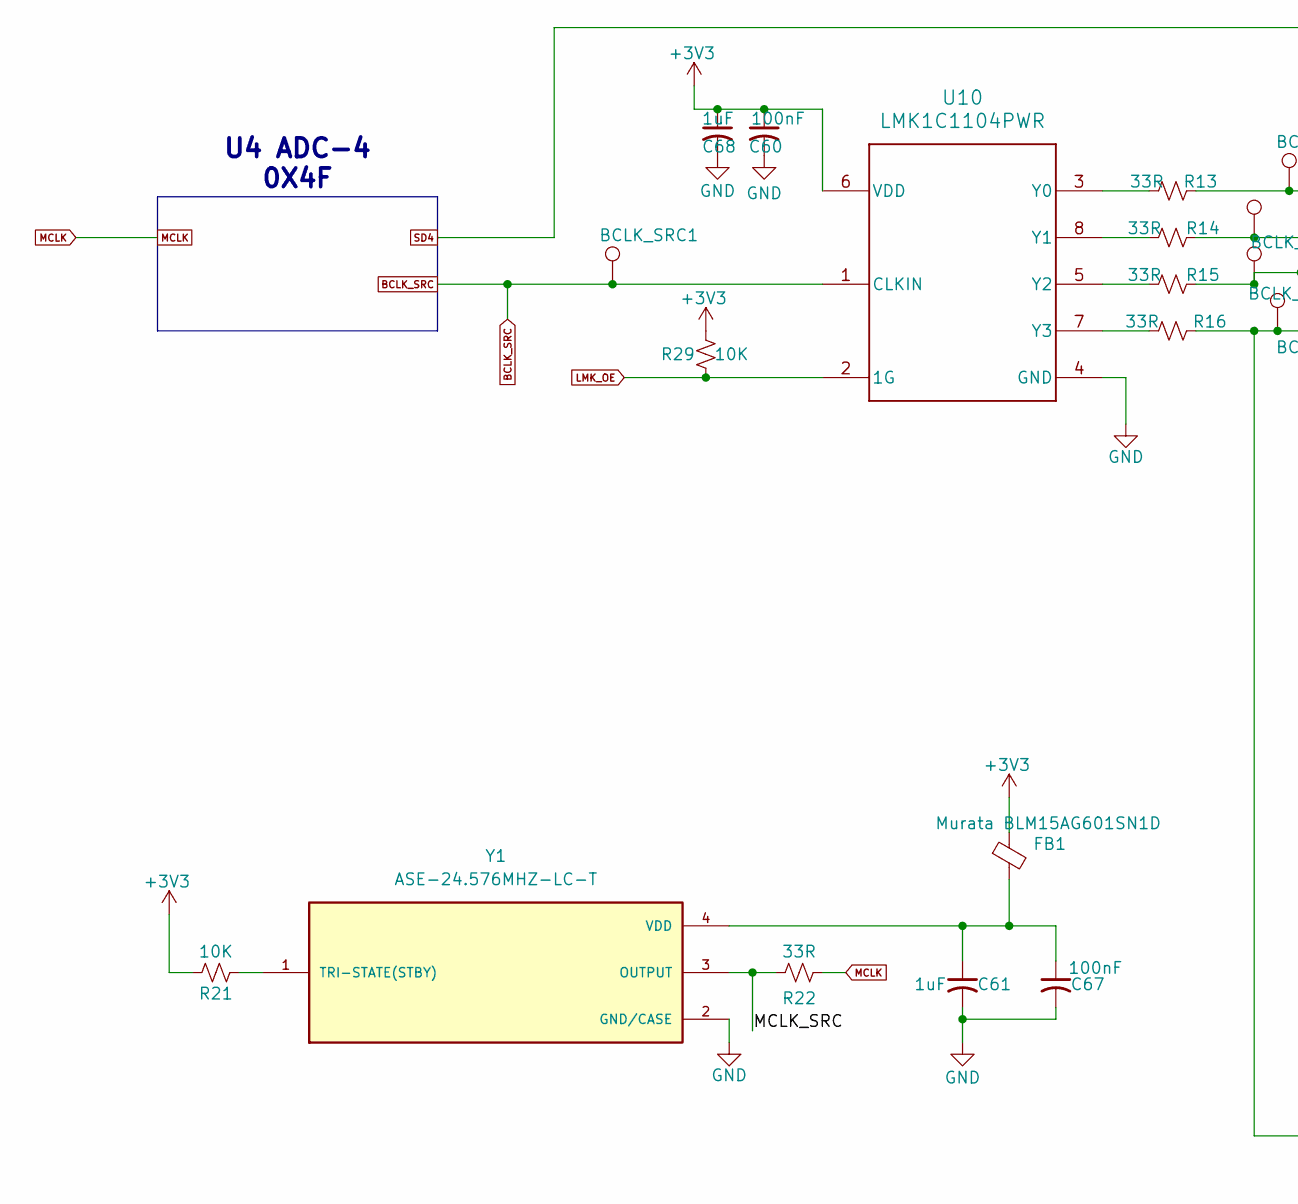
[picture p2: schematic tdm.kicad_sch, Sound Source Localization_Beam forming, part in row 1, column 1]

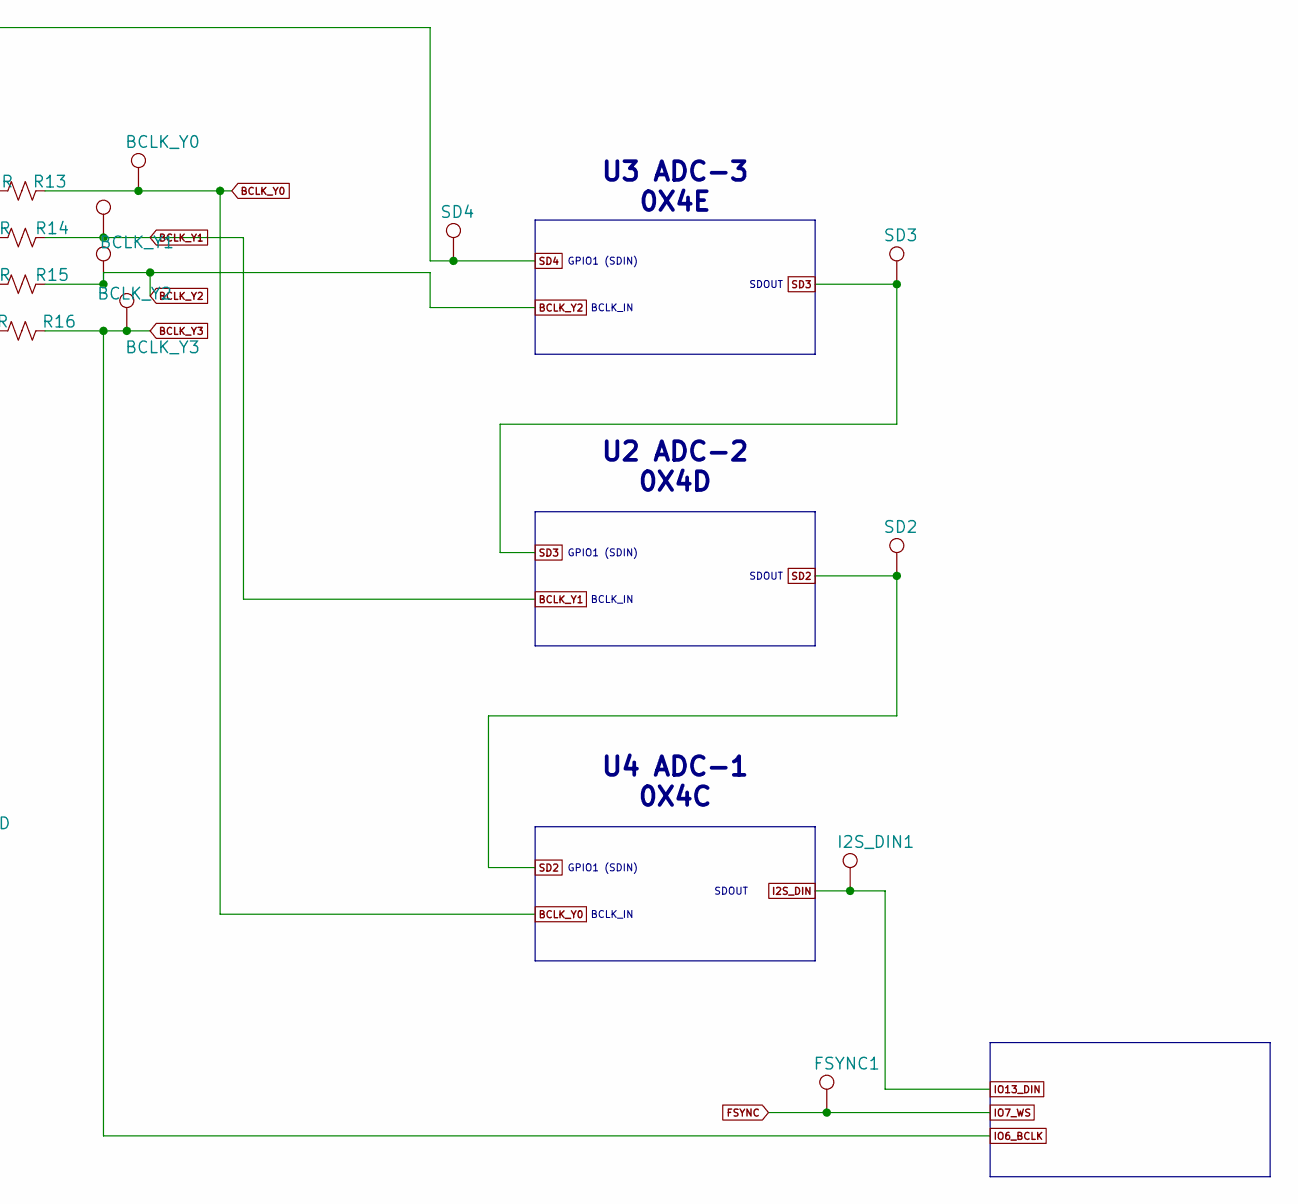
[picture p3: schematic tdm.kicad_sch, Sound Source Localization_Beam forming, part in row 1, column 2]

Parts:
BCLK_SRC1: TestPoint; TestPoint_Pad_D1.5mm
BCLK_Y0, BCLK_Y1, BCLK_Y2, BCLK_Y3: TestPoint; TestPoint_Pad_D1.5mm
C60, C67: 100nF; C_0402_1005Metric
C61, C68: 1uF; C_0402_1005Metric
FB1: Murata BLM15AG601SN1D; BEADC1005X55N
FSYNC1: TestPoint; TestPoint_Pad_D1.5mm
I2S_DIN1: TestPoint; TestPoint_Pad_D1.5mm
R13, R14, R15, R16, R22: 33R; R_0402_1005Metric
R21, R29: 10K; R_0402_1005Metric
SD2, SD3, SD4: TestPoint; TestPoint_Pad_D1.5mm
U10: LMK1C1104PWR; PW0008A-IPC_A
Y1: ASE-24.576MHZ-LC-T; XTAL_ASE-24.576MHZ-LC-T; PARTREV 02-18-22

Connections:
+3V3: C60.1, C68.1, FB1.1, R21.2, R29.1, U10.6 (VDD); also elsewhere on the board
/TDM/MCLK_SRC: R22.2, Y1.3 (OUTPUT)
BCLK_SRC: BCLK_SRC1.1 (1_1), U10.1 (CLKIN); also elsewhere on the board
BCLK_Y0: BCLK_Y0.1 (1_1), R13.1; also elsewhere on the board
BCLK_Y1: BCLK_Y1.1 (1_1), R14.1; also elsewhere on the board
BCLK_Y2: BCLK_Y2.1 (1_1), R15.1; also elsewhere on the board
BCLK_Y3: BCLK_Y3.1 (1_1), R16.1; also elsewhere on the board
FSYNC: FSYNC1.1 (1_1); also elsewhere on the board
GND: C60.2, C61.2, C67.2, C68.2, U10.4 (GND), Y1.2 (GND/CASE); also elsewhere on the board
I2S_DIN: I2S_DIN1.1 (1_1); also elsewhere on the board
LMK_OE: R29.2, U10.2 (1G)
MCLK: R22.1; also elsewhere on the board
unnamed: R13.2, U10.3 (Y0)
unnamed: R14.2, U10.8 (Y1)
unnamed: R15.2, U10.5 (Y2)
unnamed: R16.2, U10.7 (Y3)
unnamed: R21.1, Y1.1 (TRI-STATE(STBY))
unnamed: C61.1, C67.1, FB1.2, Y1.4 (VDD)
SD2: SD2.1 (1_1); also elsewhere on the board
SD3: SD3.1 (1_1); also elsewhere on the board
SD4: SD4.1 (1_1); also elsewhere on the board

Notes on the sheet:
BCLK_IN
GPIO1 (SDIN)
U4 ADC-1 0X4C
SDOUT
U4 ADC-4 0X4F
U2 ADC-2 0X4D
U3 ADC-3 0X4E

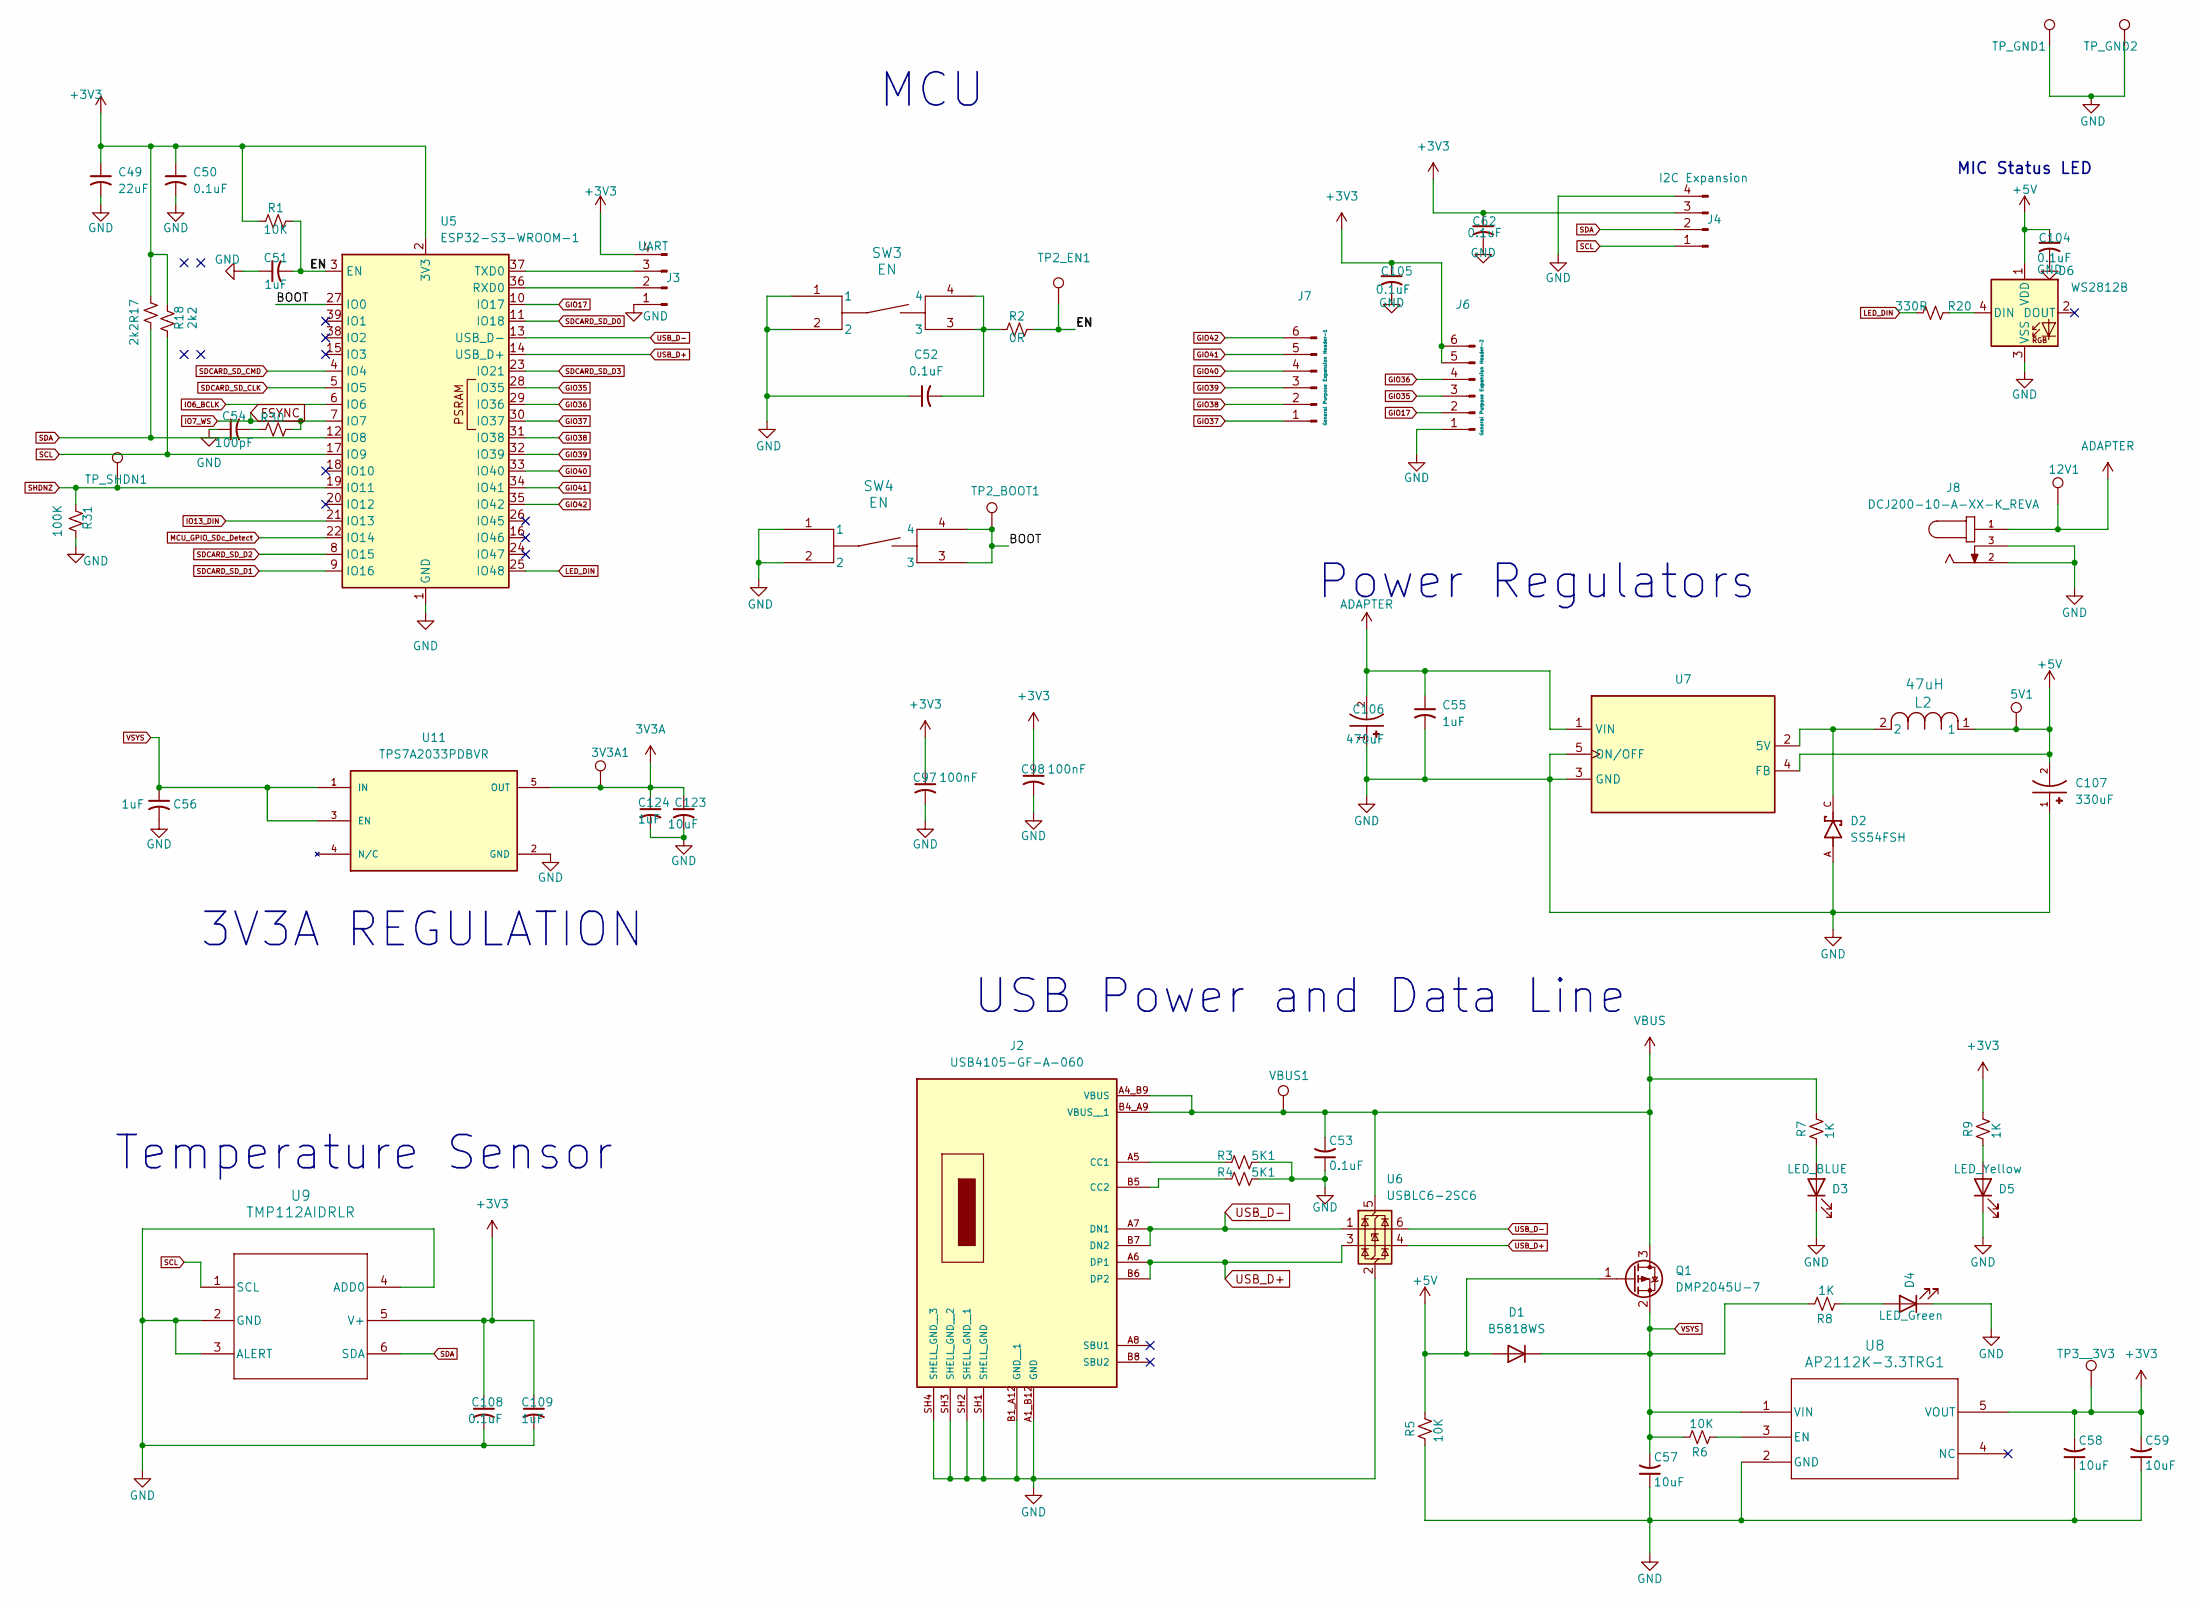
[picture p4: schematic MCU_sch.kicad_sch, Sound Source Localization_Beam forming]

Parts:
3V3A1: TestPoint; TestPoint_Plated_Hole_D2.0mm
5V1: TestPoint_Plated_Hole_D2.0mm
12V1: TestPoint; TestPoint_Plated_Hole_D3.0mm
C49: 22uF; C_1206_3216Metric
C50, C52, C53, C62, C104, C105, C108: 0.1uF; C_0402_1005Metric
C51, C109, C124: 1uF; C_0402_1005Metric
C54: 100pF; C_0402_1005Metric
C55, C56: 1uF; C_1206_3216Metric
C57, C58, C59: 10uF; C_0603_1608Metric
C97, C98: 100nF; C_0402_1005Metric
C106: 470uF; CAP_EEEFK1V471AQ; PARTREV 10-Oct-19
C107: 330uF; CAP_EEEFK1V471AQ; PARTREV 10-Oct-19
C123: 10uF; C_0805_2012Metric_Pad1.18x1.45mm_HandSolder
D1: B5818WS; D_SOD-323
D2: SS54FSH; SODFL4725X110N; PARTREV B2103
D3: LED_BLUE; LED_0603_1608Metric
D4: LED_Green; LED_0603_1608Metric
D5: LED_Yellow; LED_0603_1608Metric
D6: WS2812B; LED_WS2812B_PLCC4_5.0x5.0mm_P3.2mm
J2: USB4105-GF-A-060; GCT_USB4105-GF-A-060; PARTREV B3
J3: UART; PinHeader_1x04_P2.00mm_Vertical
J4: I2C Expansion; PinHeader_1x04_P2.00mm_Vertical
J6: General Purpose Expansion Header-2; PinHeader_1x06_P2.00mm_Vertical
J7: General Purpose Expansion Header-1; PinHeader_1x06_P2.00mm_Vertical
J8: DCJ200-10-A-XX-K_REVA; GCT_DCJ200-10-A-XX-K_REVA; PARTREV A
L2: 47uH; IND_AMRM00101040_PUL
Q1: DMP2045U-7; SOT-23
R1, R5, R6: 10K; R_0402_1005Metric
R2: 0R; R_0402_1005Metric
R3, R4: 5K1; R_0402_1005Metric
R7, R8, R9: 1K; R_0402_1005Metric
R17, R18: 2k2; R_0402_1005Metric
R20: 330R; R_0402_1005Metric
R30: 51R; R_0402_1005Metric
R31: 100K; R_0402_1005Metric
SW3, SW4: EN; SON4_PTS526 SM15 SMTR2 LFS_CNK
TP2_BOOT1, TP3__3V3: TestPoint_Plated_Hole_D2.0mm
TP2_EN1: TestPoint_Pad_D1.5mm
TP_GND1, TP_GND2: TestPoint; TestPoint_Plated_Hole_D3.0mm
TP_SHDN1: TestPoint; TestPoint_Pad_D1.5mm
U5: ESP32-S3-WROOM-1
U6: USBLC6-2SC6; SOT-23-6
U7: 3A 150KHz 40V Buck DC to DC Converter; TO-263-5_TabPin3; LCSC Part Number C74190
U8: AP2112K-3.3TRG1; SOT_RG1_DIO
U9: TMP112AIDRLR; DRL0006A
U11: TPS7A2033PDBVR; SOT95P280X145-5N; PARTREV H
VBUS1: TestPoint_Plated_Hole_D2.0mm

Connections:
3V3A: 3V3A1.1 (1_1), C123.1, C124.1, U11.5 (OUT); also elsewhere on the board
+3V3: C49.1, C50.1, C58.2, C59.2, C62.1, C97.1, C98.1, C105.1, C108.1, C109.1, J3.4, J4.3, J6.5, J6.6, R1.1, R9.2, R17.2, R18.2, TP3__3V3.1, U5.2 (3V3), U8.5 (VOUT), U9.5 (V+); also elsewhere on the board
+5V: 5V1.1 (1_1), C104.1, C107.2, D1.2 (A), D6.1 (VDD), L2.1, Q1.1 (G), R5.2, U7.4 (FB)
/MCU/BOOT: SW4.3, SW4.4, TP2_BOOT1.1 (1_1), U5.27 (IO0)
/MCU/EN: C51.2, R1.2, R2.2, TP2_EN1.1 (1_1), U5.3 (EN)
ADAPTER: 12V1.1 (1_1), C55.1, C106.2, J8.1, U7.1 (VIN)
BCLK_Y3: U5.6 (IO6); also elsewhere on the board
FSYNC: R30.1, U5.7 (IO7); also elsewhere on the board
GIO17: J6.2, U5.10 (IO17)
GIO35: J6.3, U5.28 (IO35)
GIO36: J6.4, U5.29 (IO36)
GIO37: J7.1, U5.30 (IO37)
GIO38: J7.2, U5.31 (IO38)
GIO39: J7.3, U5.32 (IO39)
GIO40: J7.4, U5.33 (IO40)
GIO41: J7.5, U5.34 (IO41)
GIO42: J7.6, U5.35 (IO42)
GND: C49.2, C50.2, C51.1, C52.1, C53.1, C54.1, C55.2, C56.2, C57.1, C58.1, C59.1, C62.2, C97.2, C98.2, C104.2, C105.2, C106.1, C107.1, C108.2, C109.2, C123.2, C124.2, D2.A, D3.1 (K), D4.1 (K), D5.1 (K), D6.3 (VSS), J2.A1_B12 (GND), J2.B1_A12 (GND__1), J2.SH1 (SHELL_GND), J2.SH2 (SHELL_GND__1), J2.SH3 (SHELL_GND__2), J2.SH4 (SHELL_GND__3), J3.1, J4.4, J6.1, J8.2, J8.3, R3.2, R4.2, R5.1, R31.1, SW3.1, SW3.2, SW4.1, SW4.2, TP_GND1.1 (1_1), TP_GND2.1 (1_1), U5.1 (GND), U5.40 (GND), U5.41 (GND), U6.2 (GND), U7.3 (GND), U7.5 (ON/OFF), U8.2 (GND), U9.2 (GND), U9.3 (ALERT), U9.4 (ADD0), U11.2 (GND); also elsewhere on the board
I2S_DIN: U5.21 (IO13); also elsewhere on the board
LED_DIN: R20.2, U5.25 (IO48)
MCU_GPIO_SDc_Detect: U5.22 (IO14); also elsewhere on the board
unnamed: C52.2, R2.1, SW3.3, SW3.4
unnamed: C54.2, R30.2
unnamed: D3.2 (A), R7.1
unnamed: D4.2 (A), R8.1
unnamed: D5.2 (A), R9.1
unnamed: D6.4 (DIN), R20.1
unnamed: J2.A5 (CC1), R3.1
unnamed: J2.B5 (CC2), R4.1
unnamed: J3.2, U5.36 (RXD0)
unnamed: J3.3, U5.37 (TXD0)
unnamed: D2.C, L2.2, U7.2 (5V)
unnamed: R6.1, U8.3 (EN)
SCL: J4.1, R18.1, U5.17 (IO9), U9.1 (SCL); also elsewhere on the board
SDA: J4.2, R17.1, U5.12 (IO8), U9.6 (SDA); also elsewhere on the board
SDCARD_SD_CLK: U5.5 (IO5); also elsewhere on the board
SDCARD_SD_CMD: U5.4 (IO4); also elsewhere on the board
SDCARD_SD_D0: U5.11 (IO18); also elsewhere on the board
SDCARD_SD_D1: U5.9 (IO16); also elsewhere on the board
SDCARD_SD_D2: U5.8 (IO15); also elsewhere on the board
SDCARD_SD_D3: U5.23 (IO21); also elsewhere on the board
SHDNZ: R31.2, TP_SHDN1.1 (1_1), U5.19 (IO11); also elsewhere on the board
USB_D+: J2.A6 (DP1), J2.B6 (DP2), U5.14 (USB_D+), U6.3 (I/O2), U6.4 (I/O2)
USB_D-: J2.A7 (DN1), J2.B7 (DN2), U5.13 (USB_D-), U6.1 (I/O1), U6.6 (I/O1)
VBUS: C53.2, J2.A4_B9 (VBUS), J2.B4_A9 (VBUS__1), Q1.3 (D), R7.2, U6.5 (VBUS), VBUS1.1 (1_1)
VSYS: C56.1, C57.2, D1.1 (K), Q1.2 (S), R6.2, R8.2, U8.1 (VIN), U11.1 (IN), U11.3 (EN)

Notes on the sheet:
MCU
Power Regulators
USB Power and Data Line
MIC Status LED
Temperature Sensor
3V3A REGULATION

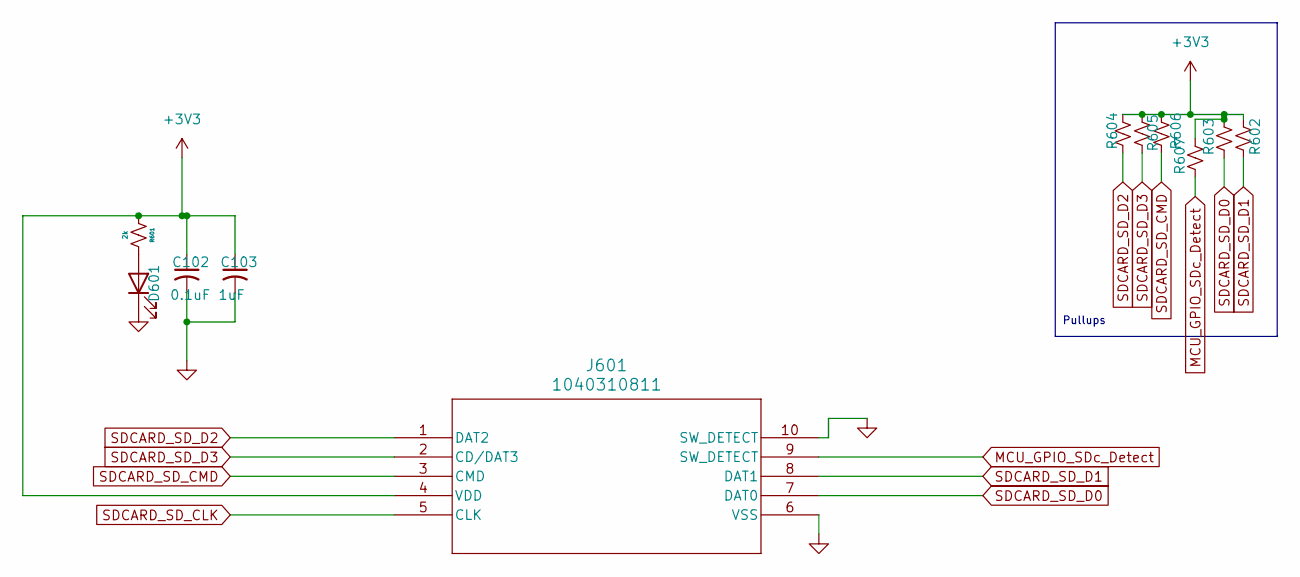
[picture p5: schematic sdcard.kicad_sch, Sound Source Localization_Beam forming]

Parts:
C102: 0.1uF; C_0603_1608Metric_Pad1.08x0.95mm_HandSolder
C103: 1uF; C_0603_1608Metric_Pad1.08x0.95mm_HandSolder
D601: LED; LED_0402_1005Metric_Pad0.77x0.64mm_HandSolder
J601: 1040310811; 104031-0811_MOL
R601: 2k; R_0402_1005Metric_Pad0.72x0.64mm_HandSolder
R602, R603, R605, R606, R607: 10K; R_0402_1005Metric_Pad0.72x0.64mm_HandSolder
R604: 10k; R_0402_1005Metric_Pad0.72x0.64mm_HandSolder

Connections:
+3V3: C102.1, C103.1, J601.4 (VDD), R601.1, R602.2, R603.2, R604.2, R605.2, R606.2, R607.2; also elsewhere on the board
GND: C102.2, C103.2, D601.1 (K), J601.6 (VSS), J601.10 (SW_DETECT), J601.11, J601.12, J601.13, J601.14; also elsewhere on the board
MCU_GPIO_SDc_Detect: J601.9 (SW_DETECT), R607.1; also elsewhere on the board
unnamed: D601.2 (A), R601.2
SDCARD_SD_CLK: J601.5 (CLK); also elsewhere on the board
SDCARD_SD_CMD: J601.3 (CMD), R606.1; also elsewhere on the board
SDCARD_SD_D0: J601.7 (DAT0), R603.1; also elsewhere on the board
SDCARD_SD_D1: J601.8 (DAT1), R602.1; also elsewhere on the board
SDCARD_SD_D2: J601.1 (DAT2), R604.1; also elsewhere on the board
SDCARD_SD_D3: J601.2 (CD/DAT3), R605.1; also elsewhere on the board

Notes on the sheet:
Pullups

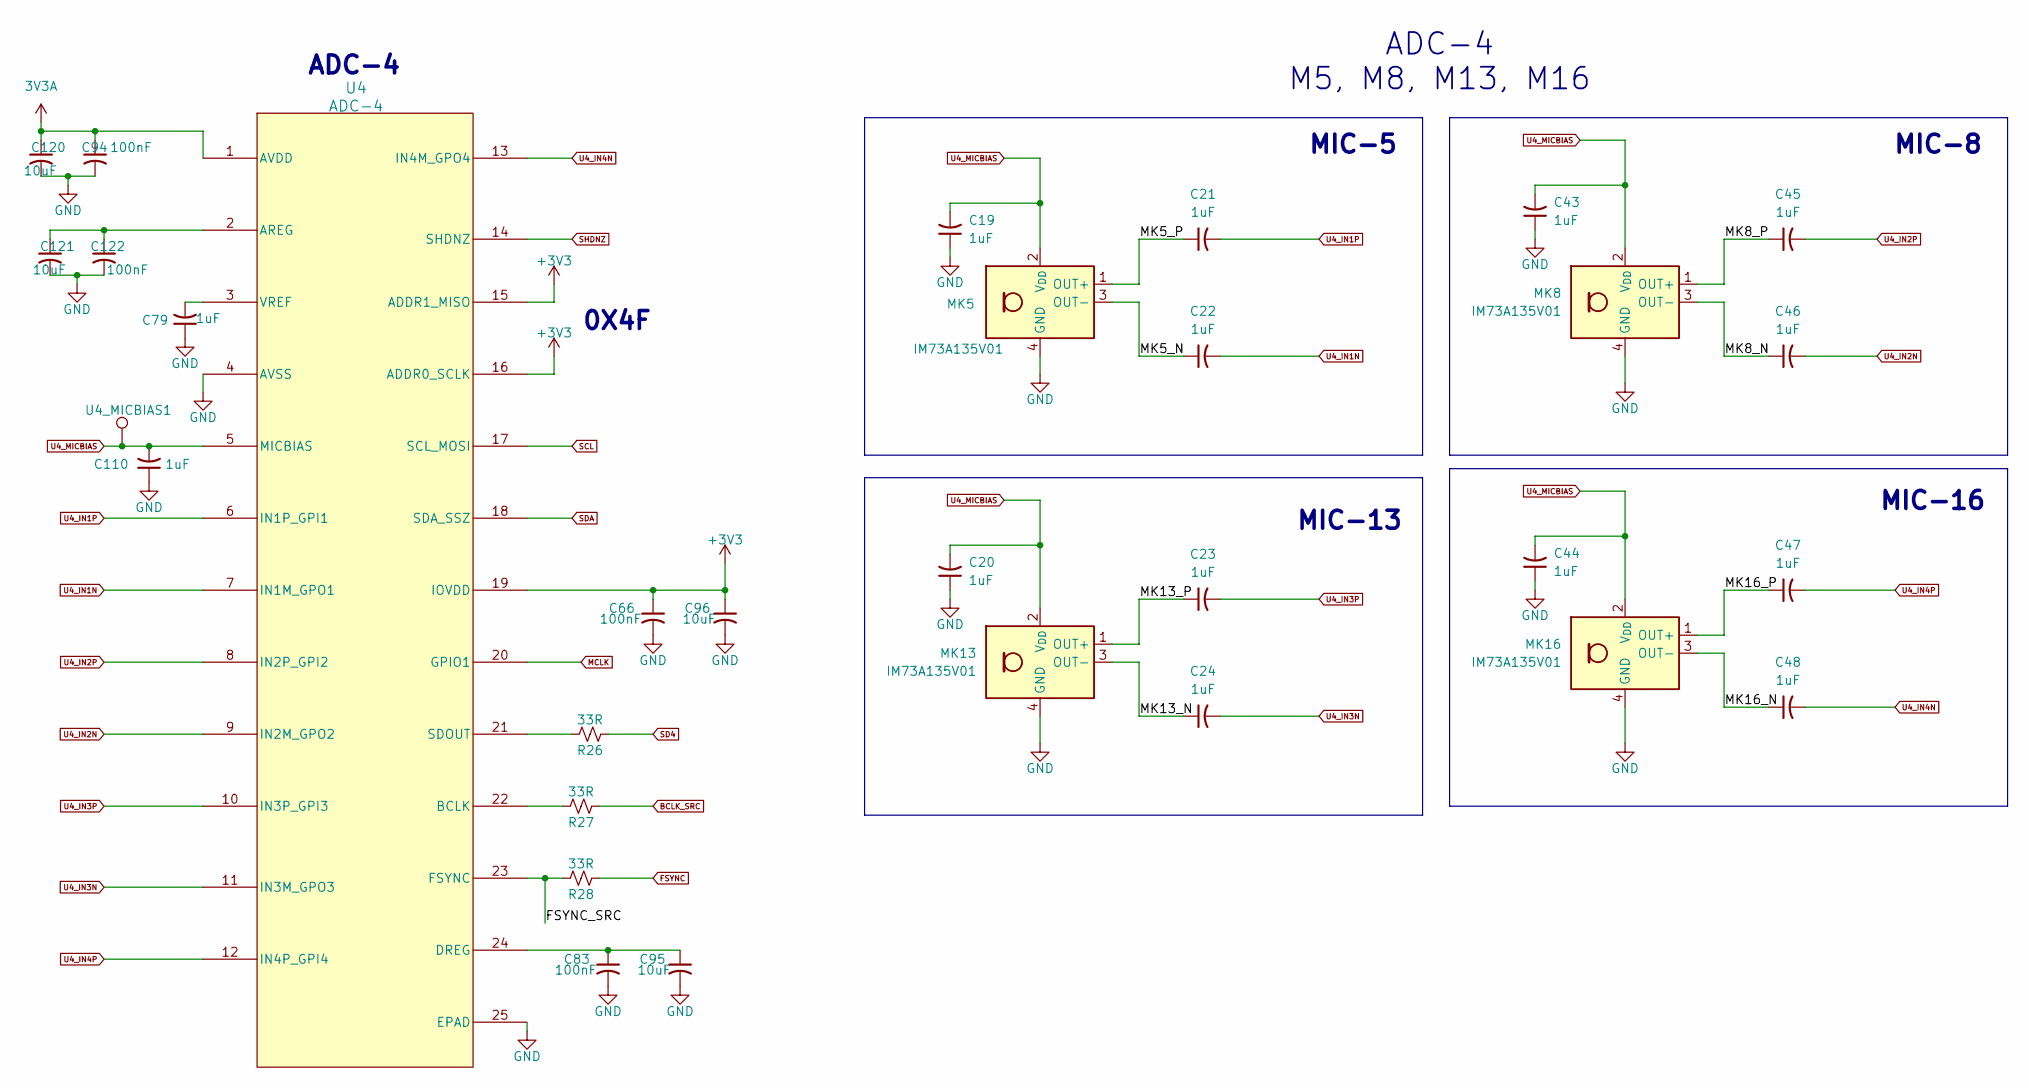
[picture p6: schematic adc_4.kicad_sch, Sound Source Localization_Beam forming]

Parts:
C19, C20, C21, C22, C23, C24, C43, C44, C45, C46, C47, C48, C79, C110: 1uF; C_0402_1005Metric
C66, C83, C94, C122: 100nF; C_0402_1005Metric
C95, C96, C120, C121: 10uF; C_0805_2012Metric_Pad1.18x1.45mm_HandSolder
MK5, MK8, MK13, MK16: IM73A135V01; Infineon_PG-LLGA-5-2
R26, R27, R28: 33R; R_0402_1005Metric
U4: ADC-4; RTW24_4P15X4P15_TEX
U4_MICBIAS1: TestPoint; TestPoint_Pad_D1.5mm

Connections:
3V3A: C94.1, C120.1, U4.1 (AVDD); also elsewhere on the board
+3V3: C66.1, C96.1, U4.15 (ADDR1_MISO), U4.16 (ADDR0_SCLK), U4.19 (IOVDD); also elsewhere on the board
/ADC_4/FSYNC_SRC: R28.2, U4.23 (FSYNC)
/ADC_4/MK5_N: C22.1, MK5.3 (OUT-)
/ADC_4/MK5_P: C21.1, MK5.1 (OUT+)
/ADC_4/MK8_N: C46.1, MK8.3 (OUT-)
/ADC_4/MK8_P: C45.1, MK8.1 (OUT+)
/ADC_4/MK13_N: C24.1, MK13.3 (OUT-)
/ADC_4/MK13_P: C23.1, MK13.1 (OUT+)
/ADC_4/MK16_N: C48.1, MK16.3 (OUT-)
/ADC_4/MK16_P: C47.1, MK16.1 (OUT+)
BCLK_SRC: R27.1; also elsewhere on the board
FSYNC: R28.1; also elsewhere on the board
GND: C19.1, C20.1, C43.1, C44.1, C66.2, C79.1, C83.2, C94.2, C95.2, C96.2, C110.1, C120.2, C121.2, C122.2, MK5.4 (GND), MK5.5 (GND), MK8.4 (GND), MK8.5 (GND), MK13.4 (GND), MK13.5 (GND), MK16.4 (GND), MK16.5 (GND), U4.4 (AVSS), U4.25 (EPAD); also elsewhere on the board
MCLK: U4.20 (GPIO1); also elsewhere on the board
unnamed: C121.1, C122.1, U4.2 (AREG)
unnamed: R27.2, U4.22 (BCLK)
unnamed: C83.1, C95.1, U4.24 (DREG)
unnamed: R26.2, U4.21 (SDOUT)
unnamed: C79.2, U4.3 (VREF)
SCL: U4.17 (SCL_MOSI); also elsewhere on the board
SD4: R26.1; also elsewhere on the board
SDA: U4.18 (SDA_SSZ); also elsewhere on the board
SHDNZ: U4.14 (SHDNZ); also elsewhere on the board
U4_IN1N: C22.2, U4.7 (IN1M_GPO1)
U4_IN1P: C21.2, U4.6 (IN1P_GPI1)
U4_IN2N: C46.2, U4.9 (IN2M_GPO2)
U4_IN2P: C45.2, U4.8 (IN2P_GPI2)
U4_IN3N: C24.2, U4.11 (IN3M_GPO3)
U4_IN3P: C23.2, U4.10 (IN3P_GPI3)
U4_IN4N: C48.2, U4.13 (IN4M_GPO4)
U4_IN4P: C47.2, U4.12 (IN4P_GPI4)
U4_MICBIAS: C19.2, C20.2, C43.2, C44.2, C110.2, MK5.2 (V_{DD}), MK8.2 (V_{DD}), MK13.2 (V_{DD}), MK16.2 (V_{DD}), U4.5 (MICBIAS), U4_MICBIAS1.1 (1_1)

Notes on the sheet:
ADC-4
MIC-16
MIC-13
ADC-4 M5, M8, M13, M16
MIC-5
MIC-8
0X4F

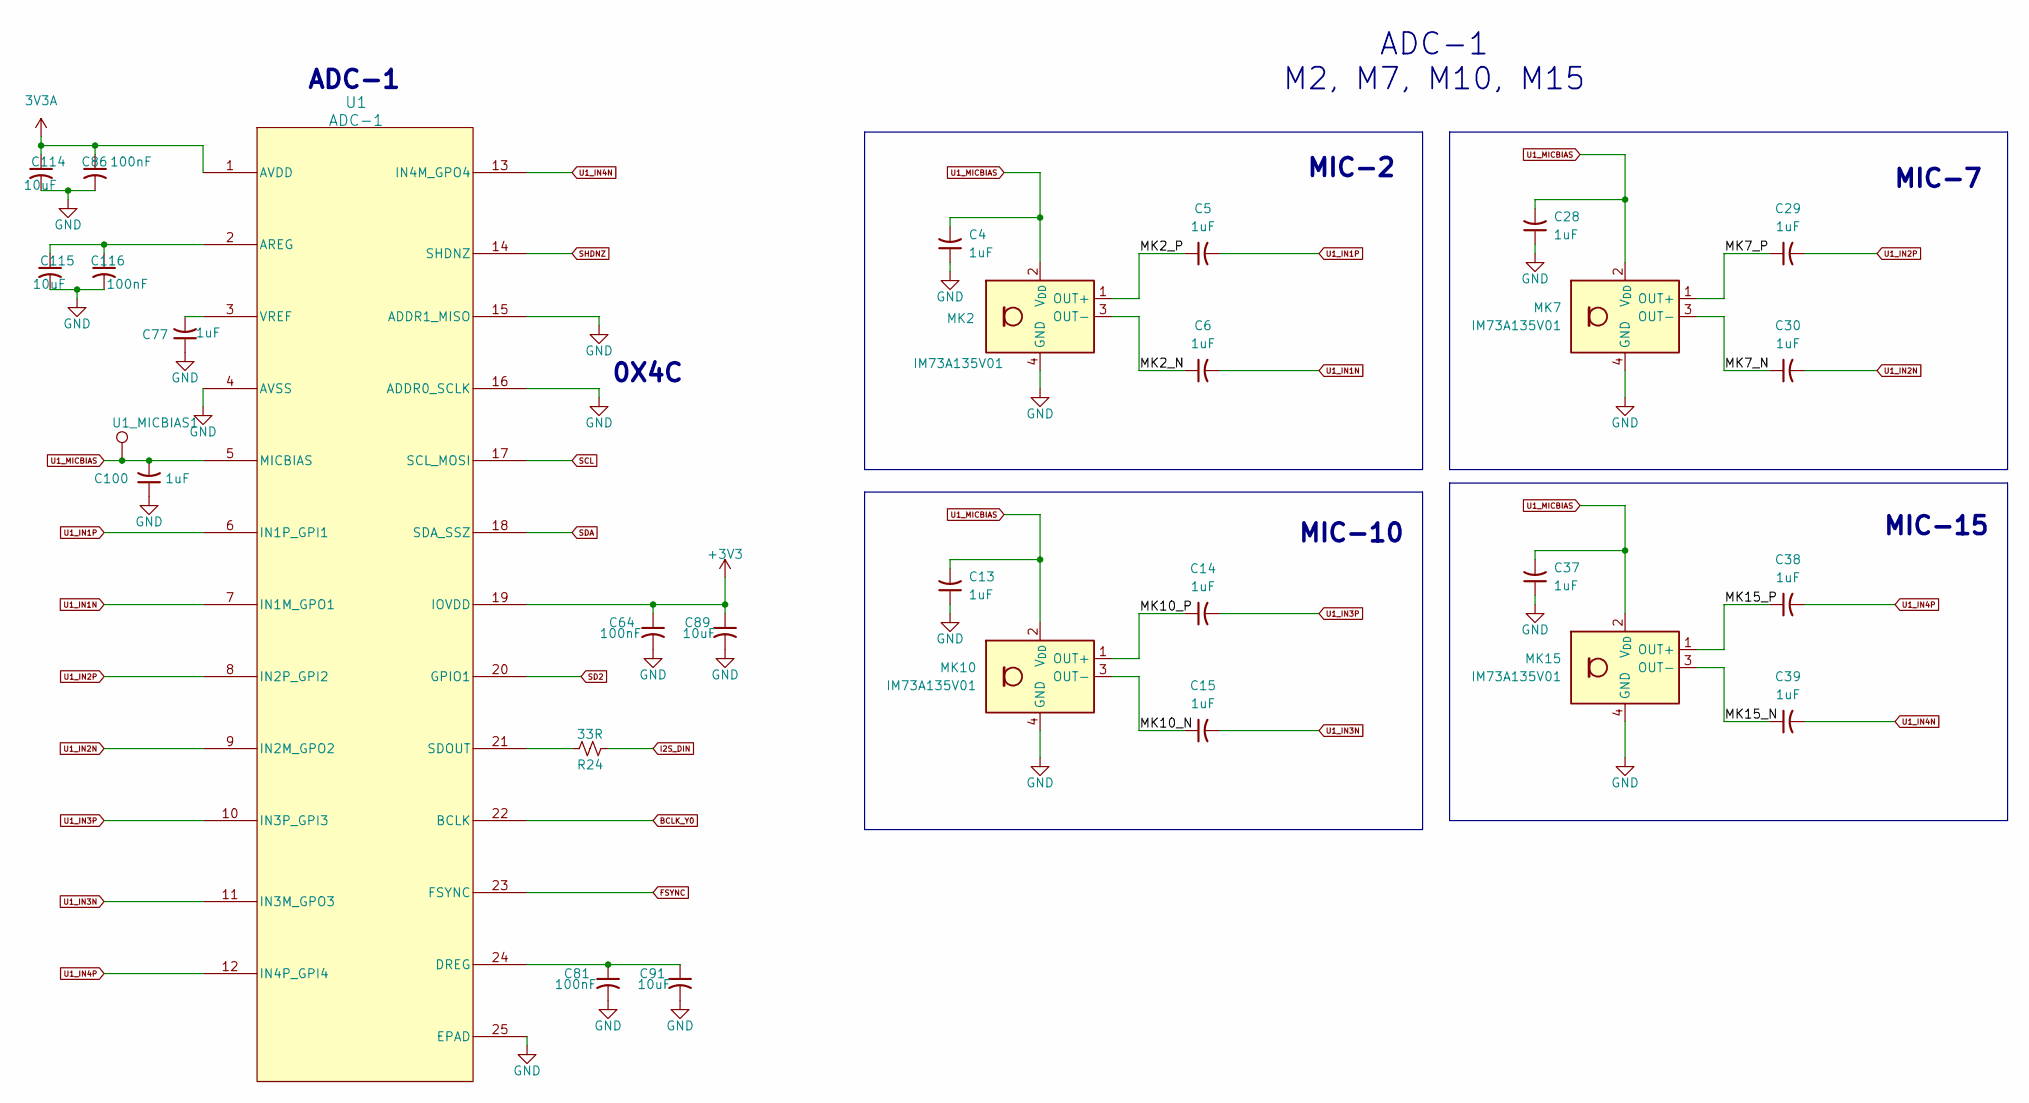
[picture p7: schematic adc_1.kicad_sch, Sound Source Localization_Beam forming]

Parts:
C4, C5, C6, C13, C14, C15, C28, C29, C30, C37, C38, C39, C77, C100: 1uF; C_0402_1005Metric
C64, C81, C86, C116: 100nF; C_0402_1005Metric
C89, C91, C114, C115: 10uF; C_0805_2012Metric_Pad1.18x1.45mm_HandSolder
MK2, MK7, MK10, MK15: IM73A135V01; Infineon_PG-LLGA-5-2
R24: 33R; R_0402_1005Metric
U1: ADC-1; RTW24_4P15X4P15_TEX
U1_MICBIAS1: TestPoint; TestPoint_Pad_D1.5mm

Connections:
3V3A: C86.1, C114.1, U1.1 (AVDD); also elsewhere on the board
+3V3: C64.1, C89.1, U1.19 (IOVDD); also elsewhere on the board
/ADC_1/MK2_N: C6.1, MK2.3 (OUT-)
/ADC_1/MK2_P: C5.1, MK2.1 (OUT+)
/ADC_1/MK7_N: C30.1, MK7.3 (OUT-)
/ADC_1/MK7_P: C29.1, MK7.1 (OUT+)
/ADC_1/MK10_N: C15.1, MK10.3 (OUT-)
/ADC_1/MK10_P: C14.1, MK10.1 (OUT+)
/ADC_1/MK15_N: C39.1, MK15.3 (OUT-)
/ADC_1/MK15_P: C38.1, MK15.1 (OUT+)
BCLK_Y0: U1.22 (BCLK); also elsewhere on the board
FSYNC: U1.23 (FSYNC); also elsewhere on the board
GND: C4.1, C13.1, C28.1, C37.1, C64.2, C77.1, C81.2, C86.2, C89.2, C91.2, C100.1, C114.2, C115.2, C116.2, MK2.4 (GND), MK2.5 (GND), MK7.4 (GND), MK7.5 (GND), MK10.4 (GND), MK10.5 (GND), MK15.4 (GND), MK15.5 (GND), U1.4 (AVSS), U1.15 (ADDR1_MISO), U1.16 (ADDR0_SCLK), U1.25 (EPAD); also elsewhere on the board
I2S_DIN: R24.1; also elsewhere on the board
unnamed: C115.1, C116.1, U1.2 (AREG)
unnamed: C81.1, C91.1, U1.24 (DREG)
unnamed: R24.2, U1.21 (SDOUT)
unnamed: C77.2, U1.3 (VREF)
SCL: U1.17 (SCL_MOSI); also elsewhere on the board
SD2: U1.20 (GPIO1); also elsewhere on the board
SDA: U1.18 (SDA_SSZ); also elsewhere on the board
SHDNZ: U1.14 (SHDNZ); also elsewhere on the board
U1_IN1N: C6.2, U1.7 (IN1M_GPO1)
U1_IN1P: C5.2, U1.6 (IN1P_GPI1)
U1_IN2N: C30.2, U1.9 (IN2M_GPO2)
U1_IN2P: C29.2, U1.8 (IN2P_GPI2)
U1_IN3N: C15.2, U1.11 (IN3M_GPO3)
U1_IN3P: C14.2, U1.10 (IN3P_GPI3)
U1_IN4N: C39.2, U1.13 (IN4M_GPO4)
U1_IN4P: C38.2, U1.12 (IN4P_GPI4)
U1_MICBIAS: C4.2, C13.2, C28.2, C37.2, C100.2, MK2.2 (V_{DD}), MK7.2 (V_{DD}), MK10.2 (V_{DD}), MK15.2 (V_{DD}), U1.5 (MICBIAS), U1_MICBIAS1.1 (1_1)

Notes on the sheet:
MIC-7
MIC-15
MIC-2
ADC-1
MIC-10
0X4C
ADC-1 M2, M7, M10, M15
