shakursiam/ssl16-acoustic-camera/hardware/kicad/Beamfoarming_16x.kicad_pcb

## KiCad design hardware/kicad/Beamfoarming_16x.kicad_pcb (continued)

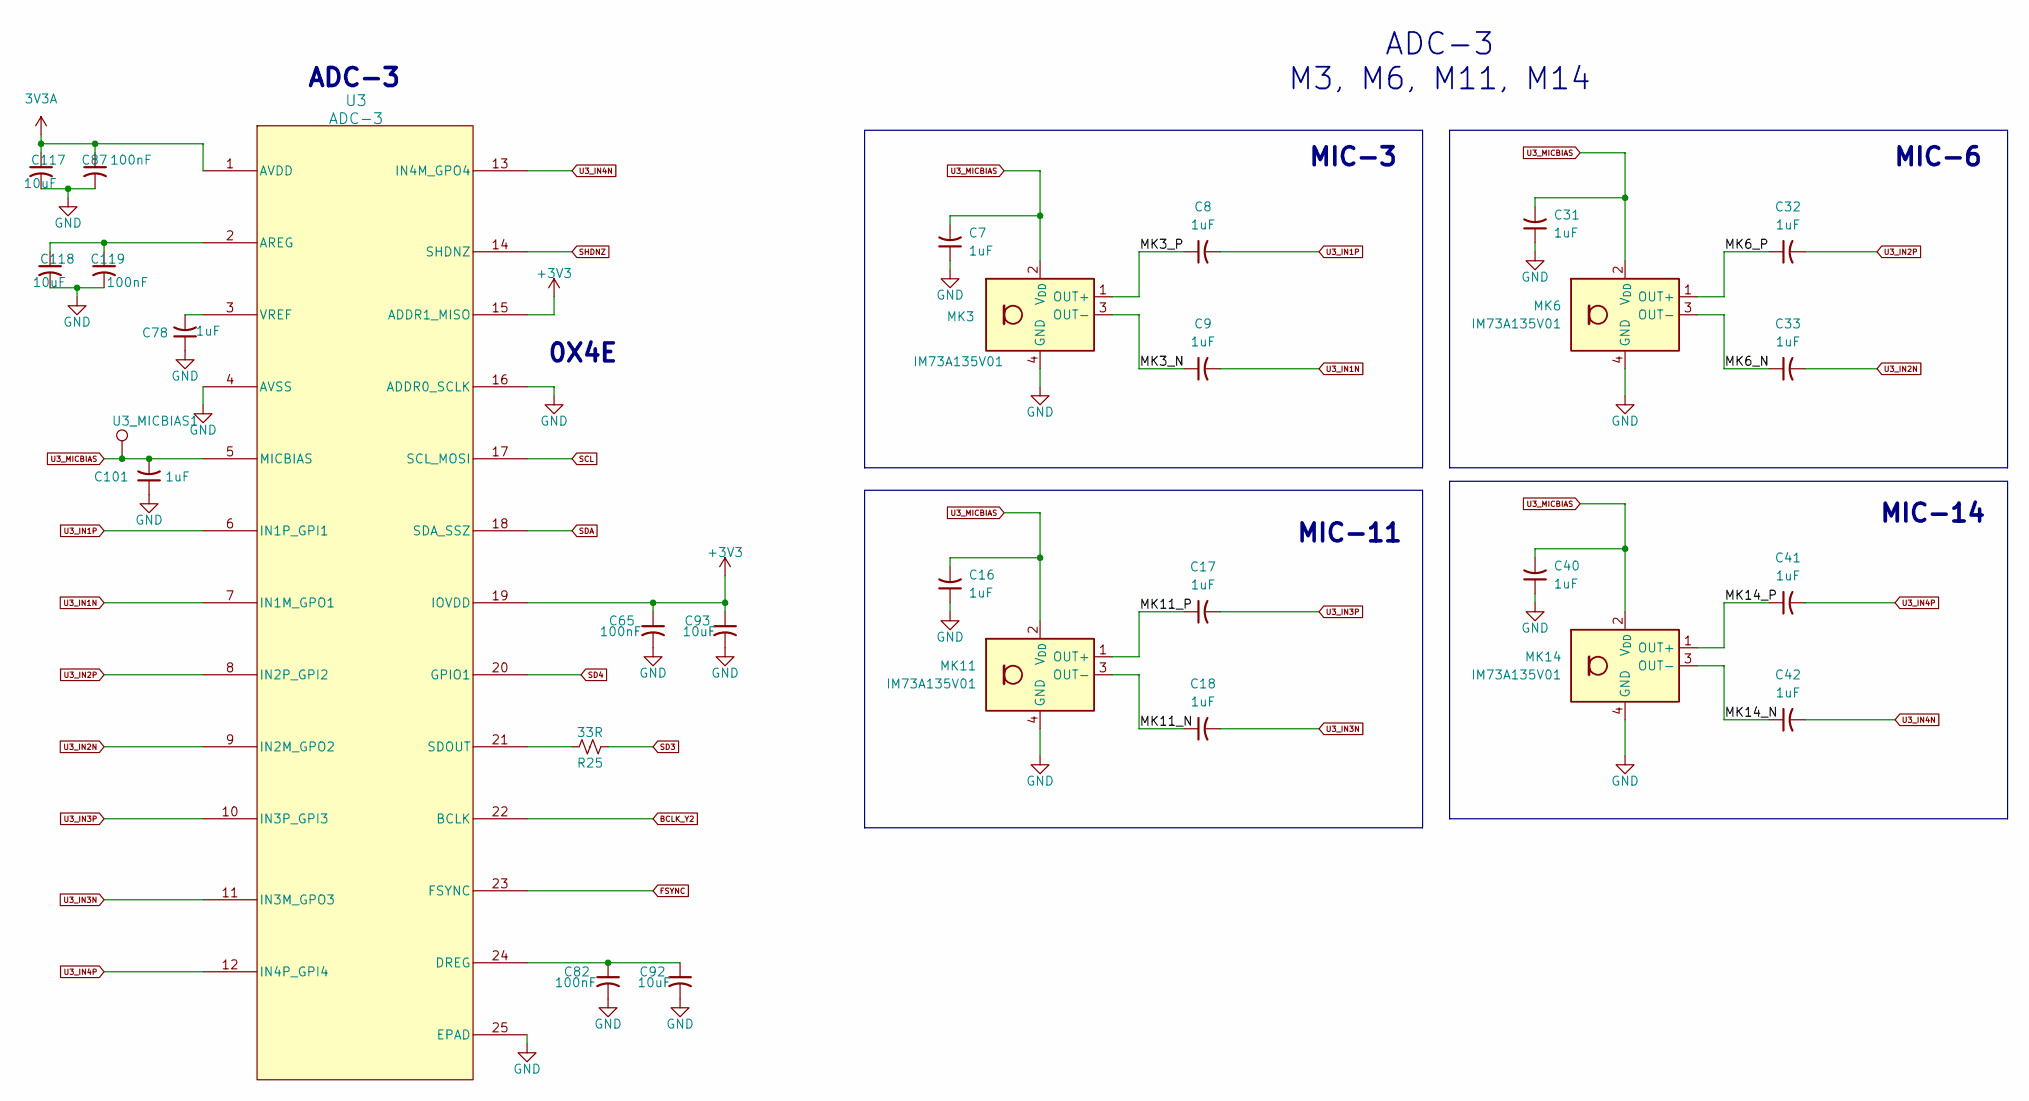
[picture p8: schematic adc_3.kicad_sch, Sound Source Localization_Beam forming]

Parts:
C7, C8, C9, C16, C17, C18, C31, C32, C33, C40, C41, C42, C78, C101: 1uF; C_0402_1005Metric
C65, C82, C87, C119: 100nF; C_0402_1005Metric
C92, C93, C117, C118: 10uF; C_0805_2012Metric_Pad1.18x1.45mm_HandSolder
MK3, MK6, MK11, MK14: IM73A135V01; Infineon_PG-LLGA-5-2
R25: 33R; R_0402_1005Metric
U3: ADC-3; RTW24_4P15X4P15_TEX
U3_MICBIAS1: TestPoint; TestPoint_Pad_D1.5mm

Connections:
3V3A: C87.1, C117.1, U3.1 (AVDD); also elsewhere on the board
+3V3: C65.1, C93.1, U3.15 (ADDR1_MISO), U3.19 (IOVDD); also elsewhere on the board
/ADC_3/MK3_N: C9.1, MK3.3 (OUT-)
/ADC_3/MK3_P: C8.1, MK3.1 (OUT+)
/ADC_3/MK6_N: C33.1, MK6.3 (OUT-)
/ADC_3/MK6_P: C32.1, MK6.1 (OUT+)
/ADC_3/MK11_N: C18.1, MK11.3 (OUT-)
/ADC_3/MK11_P: C17.1, MK11.1 (OUT+)
/ADC_3/MK14_N: C42.1, MK14.3 (OUT-)
/ADC_3/MK14_P: C41.1, MK14.1 (OUT+)
BCLK_Y2: U3.22 (BCLK); also elsewhere on the board
FSYNC: U3.23 (FSYNC); also elsewhere on the board
GND: C7.1, C16.1, C31.1, C40.1, C65.2, C78.1, C82.2, C87.2, C92.2, C93.2, C101.1, C117.2, C118.2, C119.2, MK3.4 (GND), MK3.5 (GND), MK6.4 (GND), MK6.5 (GND), MK11.4 (GND), MK11.5 (GND), MK14.4 (GND), MK14.5 (GND), U3.4 (AVSS), U3.16 (ADDR0_SCLK), U3.25 (EPAD); also elsewhere on the board
unnamed: C118.1, C119.1, U3.2 (AREG)
unnamed: C82.1, C92.1, U3.24 (DREG)
unnamed: R25.2, U3.21 (SDOUT)
unnamed: C78.2, U3.3 (VREF)
SCL: U3.17 (SCL_MOSI); also elsewhere on the board
SD3: R25.1; also elsewhere on the board
SD4: U3.20 (GPIO1); also elsewhere on the board
SDA: U3.18 (SDA_SSZ); also elsewhere on the board
SHDNZ: U3.14 (SHDNZ); also elsewhere on the board
U3_IN1N: C9.2, U3.7 (IN1M_GPO1)
U3_IN1P: C8.2, U3.6 (IN1P_GPI1)
U3_IN2N: C33.2, U3.9 (IN2M_GPO2)
U3_IN2P: C32.2, U3.8 (IN2P_GPI2)
U3_IN3N: C18.2, U3.11 (IN3M_GPO3)
U3_IN3P: C17.2, U3.10 (IN3P_GPI3)
U3_IN4N: C42.2, U3.13 (IN4M_GPO4)
U3_IN4P: C41.2, U3.12 (IN4P_GPI4)
U3_MICBIAS: C7.2, C16.2, C31.2, C40.2, C101.2, MK3.2 (V_{DD}), MK6.2 (V_{DD}), MK11.2 (V_{DD}), MK14.2 (V_{DD}), U3.5 (MICBIAS), U3_MICBIAS1.1 (1_1)

Notes on the sheet:
MIC-6
ADC-3 M3, M6, M11, M14
0X4E
MIC-14
ADC-3
MIC-3
MIC-11

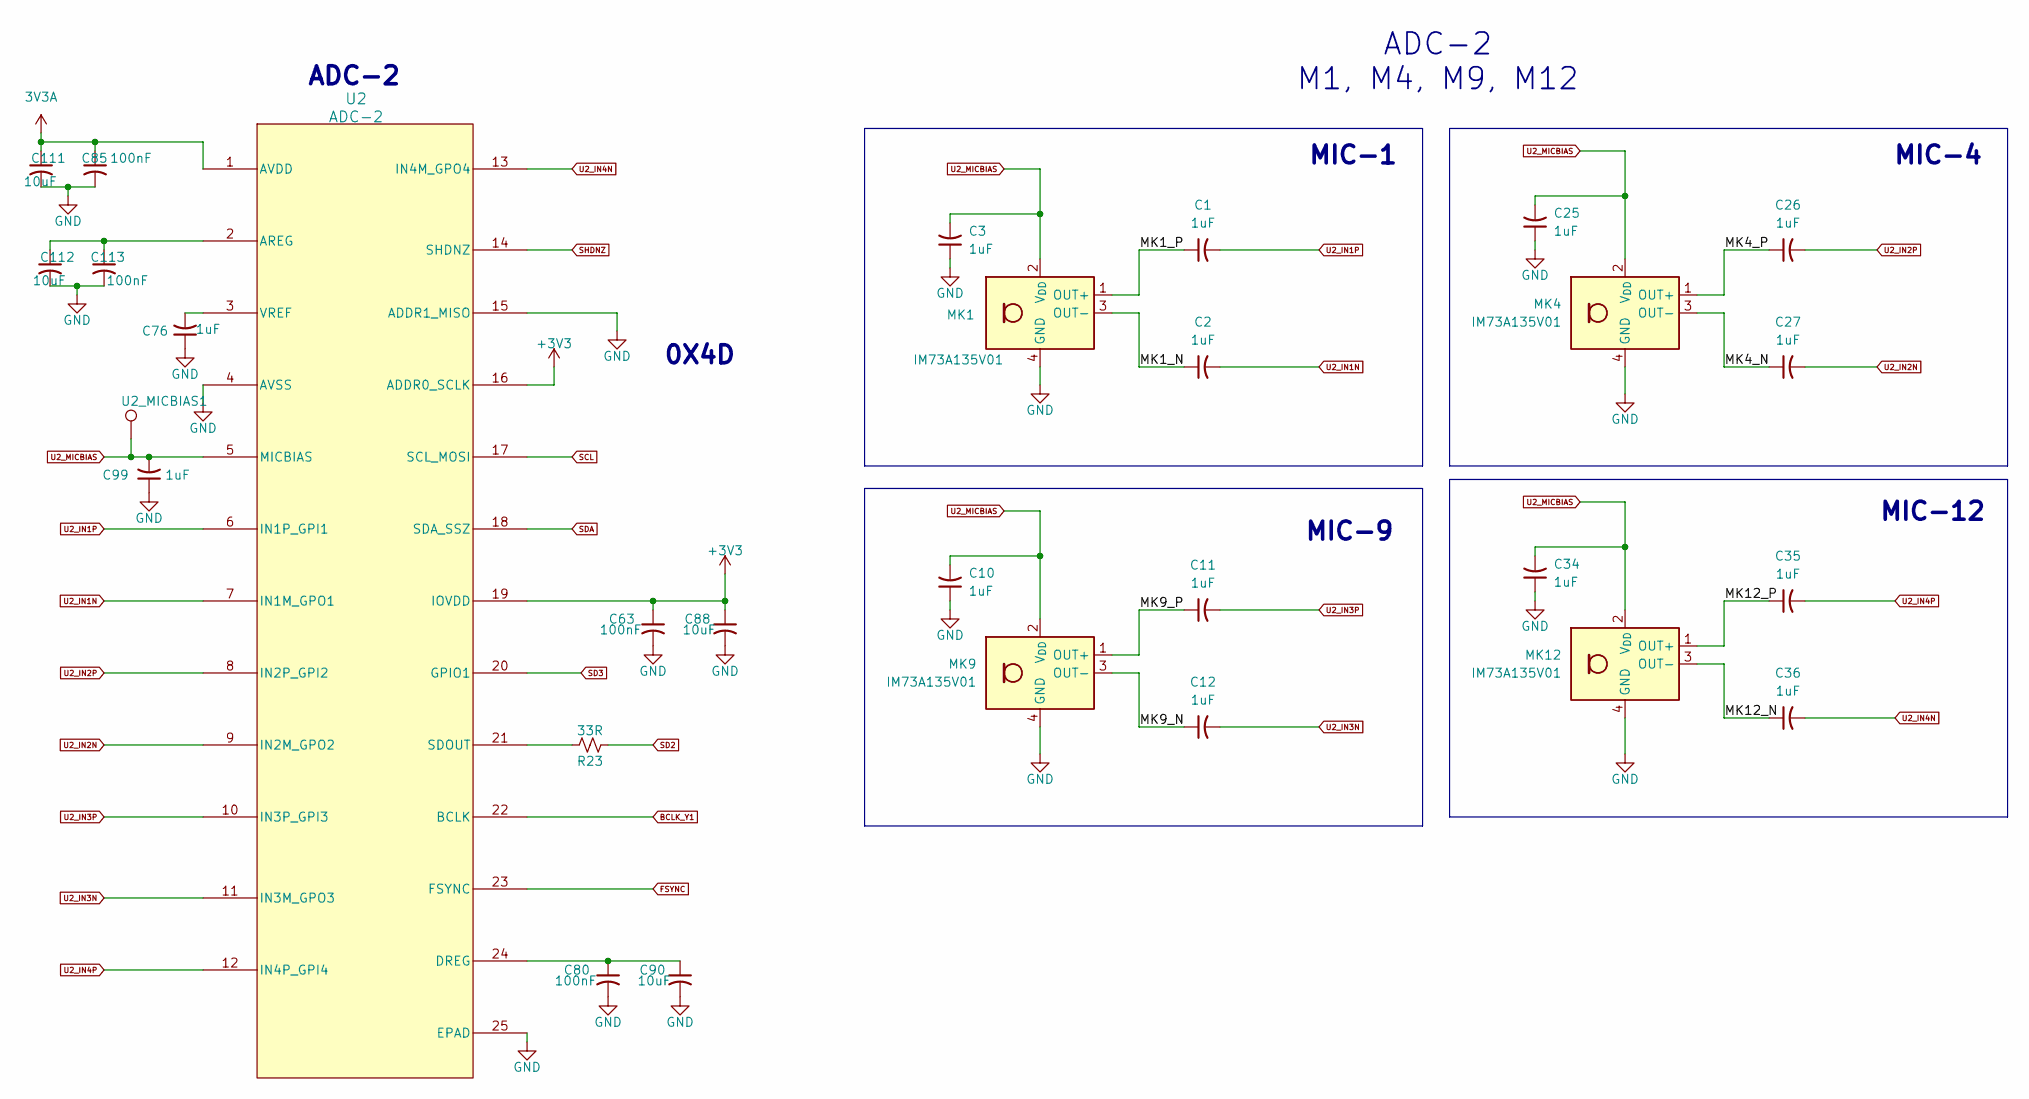
[picture p9: schematic adc_2.kicad_sch, Sound Source Localization_Beam forming]

Parts:
C1, C2, C3, C10, C11, C12, C25, C26, C27, C34, C35, C36, C76, C99: 1uF; C_0402_1005Metric
C63, C80, C85, C113: 100nF; C_0402_1005Metric
C88, C90, C111, C112: 10uF; C_0805_2012Metric_Pad1.18x1.45mm_HandSolder
MK1, MK4, MK9, MK12: IM73A135V01; Infineon_PG-LLGA-5-2
R23: 33R; R_0402_1005Metric
U2: ADC-2; RTW24_4P15X4P15_TEX
U2_MICBIAS1: TestPoint; TestPoint_Pad_D1.5mm

Connections:
3V3A: C85.1, C111.1, U2.1 (AVDD); also elsewhere on the board
+3V3: C63.1, C88.1, U2.16 (ADDR0_SCLK), U2.19 (IOVDD); also elsewhere on the board
/ADC_2/MK1_N: C2.1, MK1.3 (OUT-)
/ADC_2/MK1_P: C1.1, MK1.1 (OUT+)
/ADC_2/MK4_N: C27.1, MK4.3 (OUT-)
/ADC_2/MK4_P: C26.1, MK4.1 (OUT+)
/ADC_2/MK9_N: C12.1, MK9.3 (OUT-)
/ADC_2/MK9_P: C11.1, MK9.1 (OUT+)
/ADC_2/MK12_N: C36.1, MK12.3 (OUT-)
/ADC_2/MK12_P: C35.1, MK12.1 (OUT+)
BCLK_Y1: U2.22 (BCLK); also elsewhere on the board
FSYNC: U2.23 (FSYNC); also elsewhere on the board
GND: C3.1, C10.1, C25.1, C34.1, C63.2, C76.1, C80.2, C85.2, C88.2, C90.2, C99.1, C111.2, C112.2, C113.2, MK1.4 (GND), MK1.5 (GND), MK4.4 (GND), MK4.5 (GND), MK9.4 (GND), MK9.5 (GND), MK12.4 (GND), MK12.5 (GND), U2.4 (AVSS), U2.15 (ADDR1_MISO), U2.25 (EPAD); also elsewhere on the board
unnamed: C112.1, C113.1, U2.2 (AREG)
unnamed: C80.1, C90.1, U2.24 (DREG)
unnamed: R23.2, U2.21 (SDOUT)
unnamed: C76.2, U2.3 (VREF)
SCL: U2.17 (SCL_MOSI); also elsewhere on the board
SD2: R23.1; also elsewhere on the board
SD3: U2.20 (GPIO1); also elsewhere on the board
SDA: U2.18 (SDA_SSZ); also elsewhere on the board
SHDNZ: U2.14 (SHDNZ); also elsewhere on the board
U2_IN1N: C2.2, U2.7 (IN1M_GPO1)
U2_IN1P: C1.2, U2.6 (IN1P_GPI1)
U2_IN2N: C27.2, U2.9 (IN2M_GPO2)
U2_IN2P: C26.2, U2.8 (IN2P_GPI2)
U2_IN3N: C12.2, U2.11 (IN3M_GPO3)
U2_IN3P: C11.2, U2.10 (IN3P_GPI3)
U2_IN4N: C36.2, U2.13 (IN4M_GPO4)
U2_IN4P: C35.2, U2.12 (IN4P_GPI4)
U2_MICBIAS: C3.2, C10.2, C25.2, C34.2, C99.2, MK1.2 (V_{DD}), MK4.2 (V_{DD}), MK9.2 (V_{DD}), MK12.2 (V_{DD}), U2.5 (MICBIAS), U2_MICBIAS1.1 (1_1)

Notes on the sheet:
0X4D
MIC-1
MIC-4
ADC-2
ADC-2 M1, M4, M9, M12
MIC-12
MIC-9

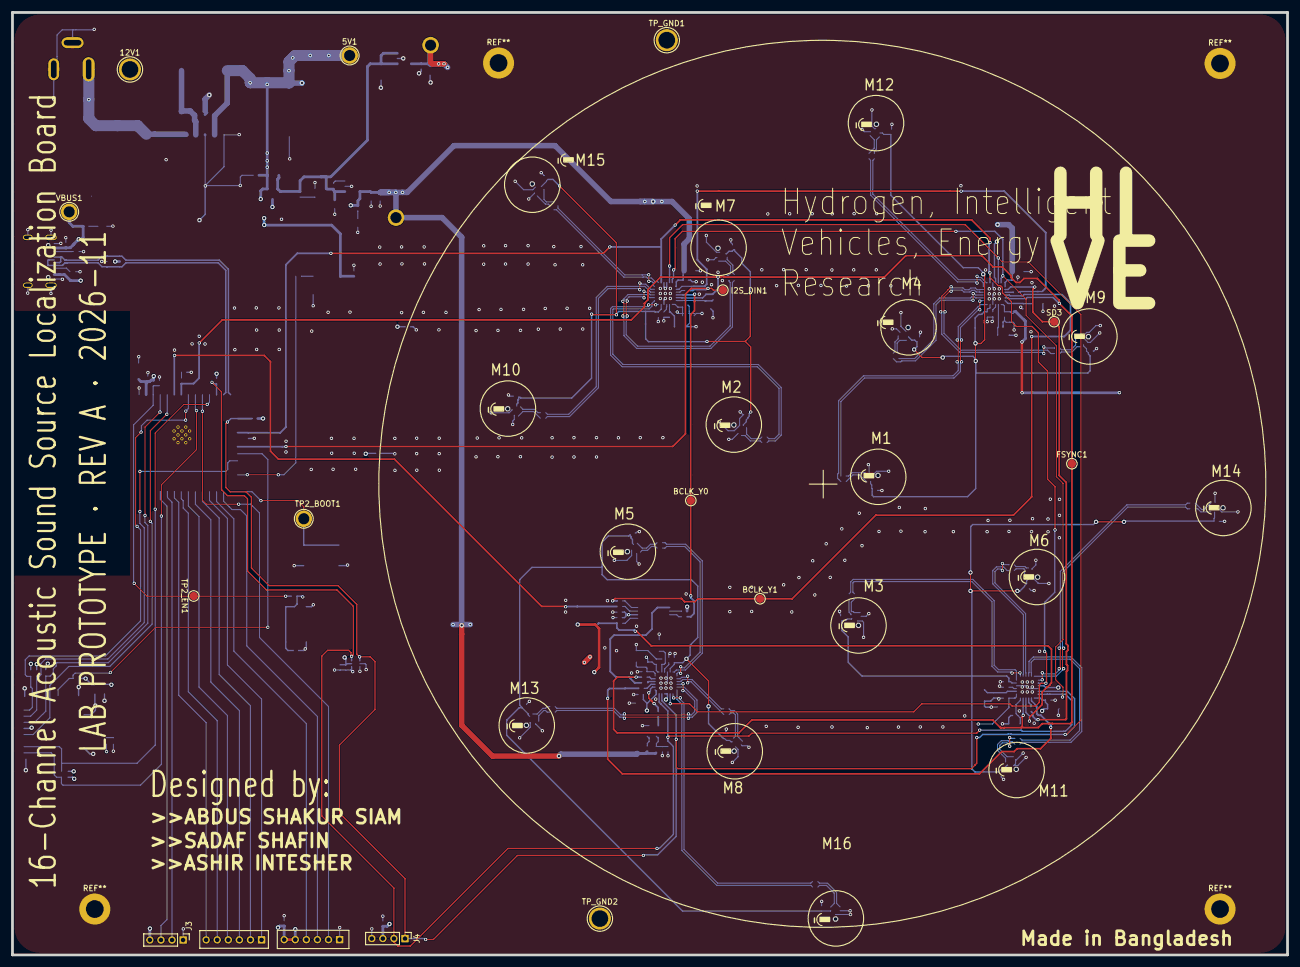
[picture p10: board Beamfoarming_16x.kicad_pcb from above]

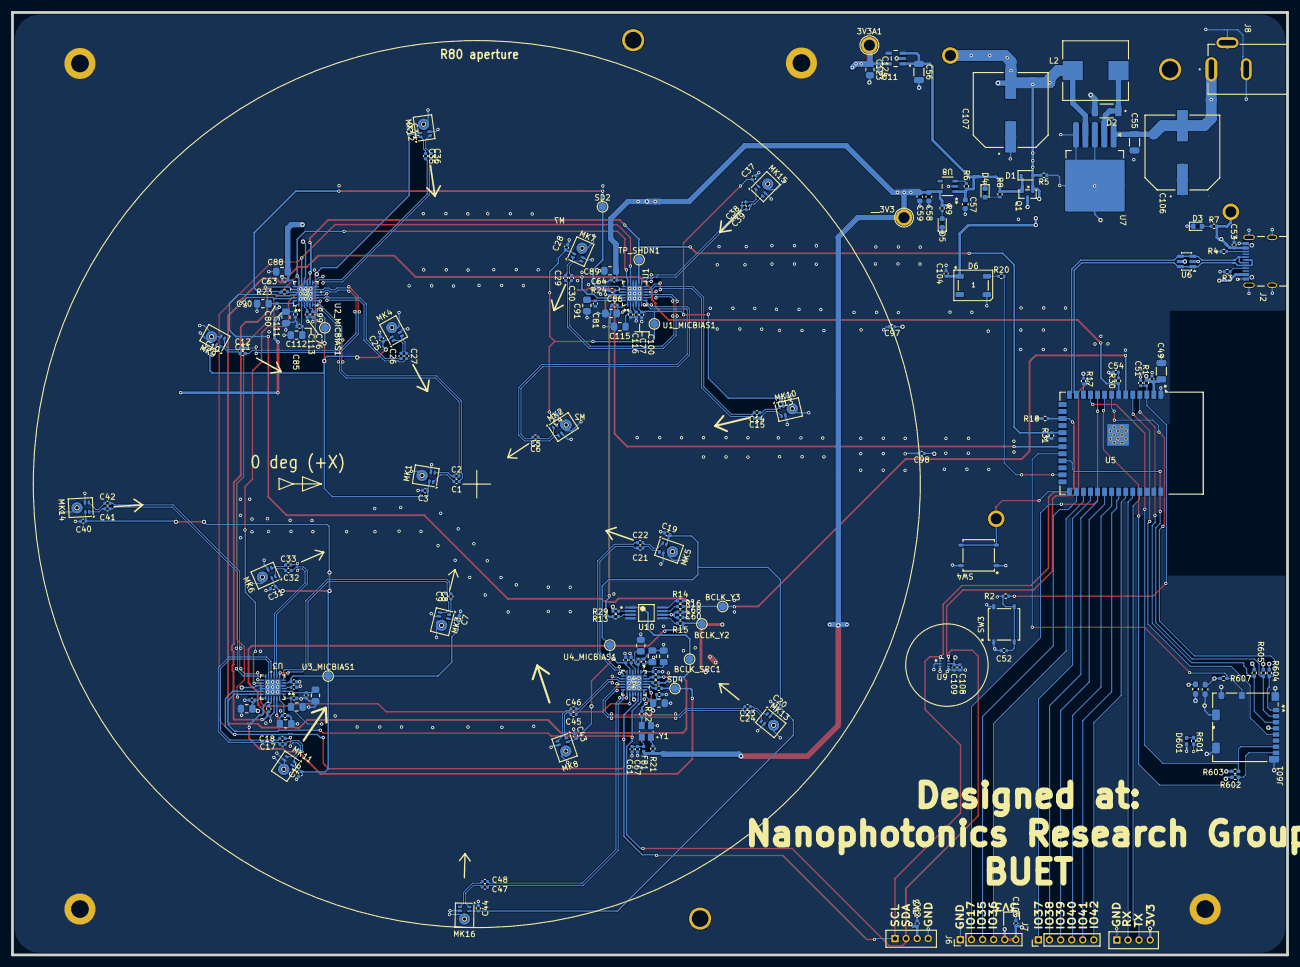
[picture p11: board Beamfoarming_16x.kicad_pcb from below]

Board: 4 copper layers, 230.0 x 170.0 mm, 221 parts (207 on the bottom side), 149 nets.

Other parts of the board:
__3V3: TestPoint_Plated_Hole_D2.0mm

Their connections:
+3V3: __3V3.1 (1_1); also elsewhere on the board
